IowaScaledEngineering/mrbw-cabbus/doc/lab/2018-02-05-cabbus.png

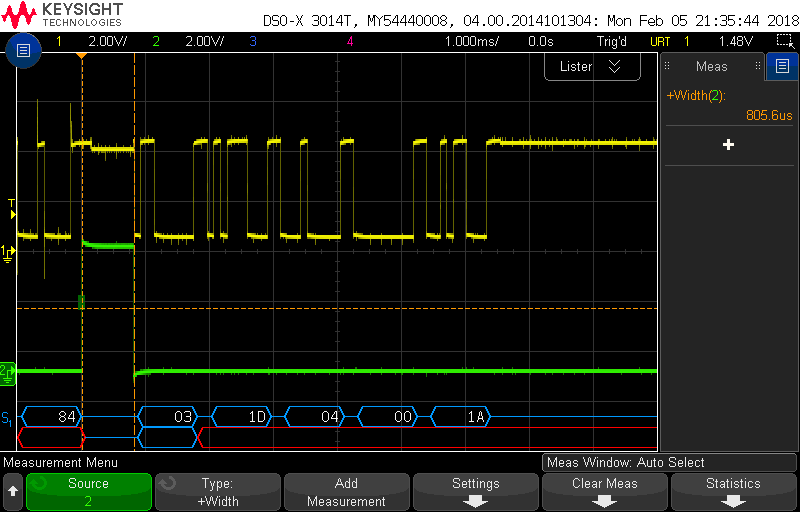
doc/lab/2018-02-05-cabbus.png
