IowaScaledEngineering/mrbw-cabbus/doc/lab/2018-02-05-xpressnet-1.png

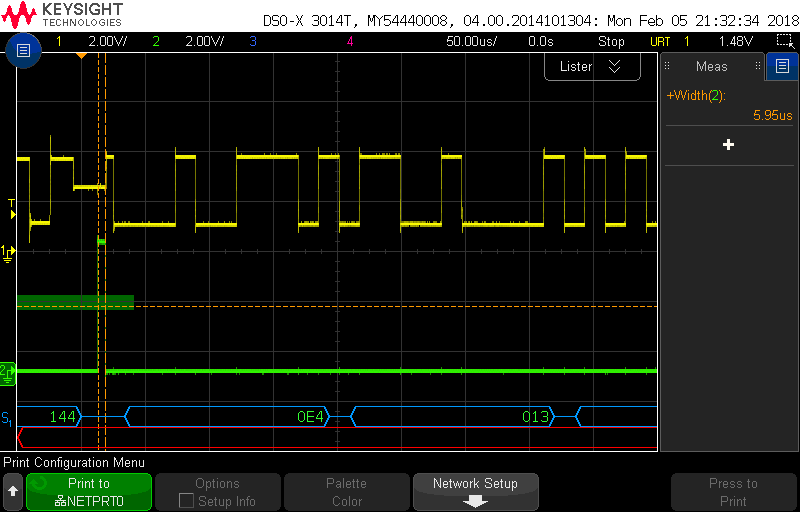
doc/lab/2018-02-05-xpressnet-1.png
