IowaScaledEngineering/mrbw-cabbus/pg/mrbw-cabbus-v2.3-62b0684/mrbw-cabbus.pdf

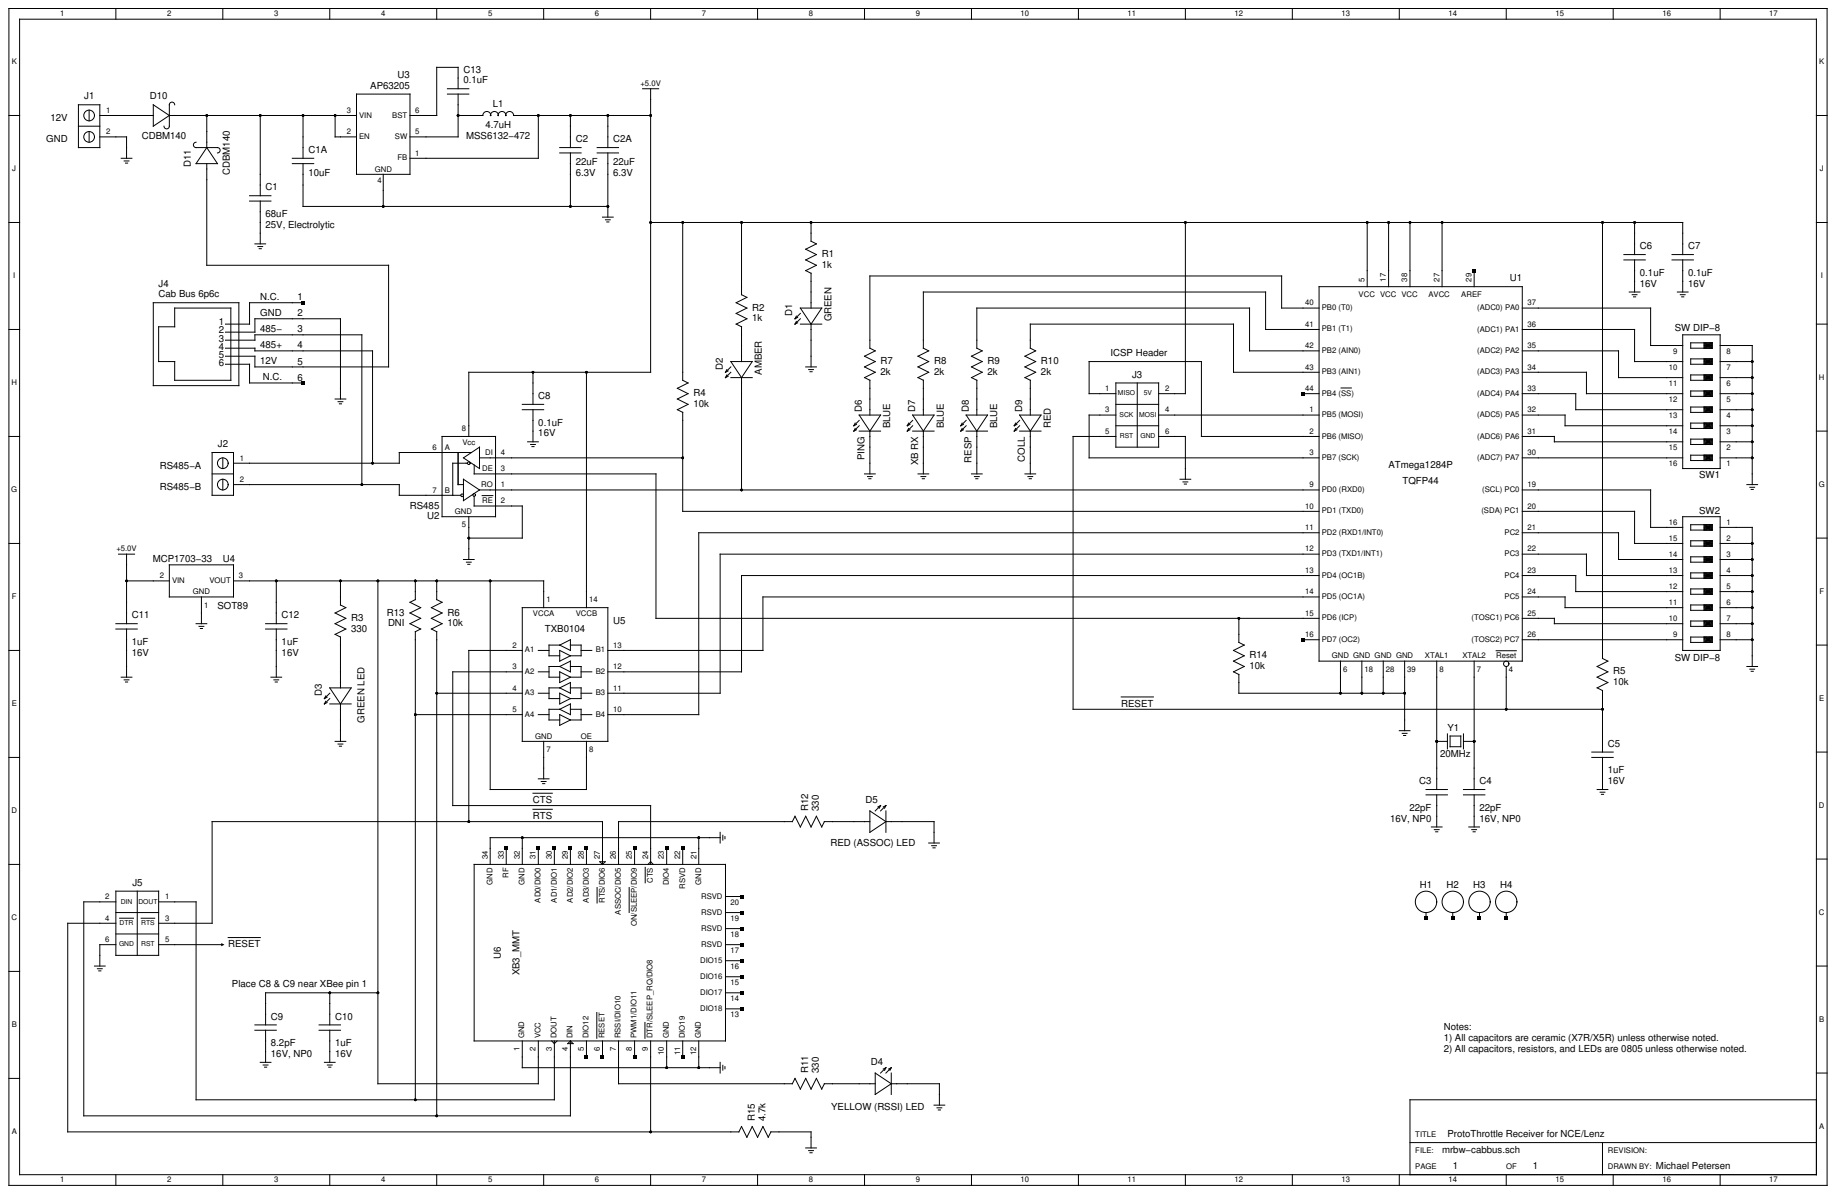
[picture p14: page 1]

32 (ADC5) PA5 | | 12 | 5

SCK | MOSI | | | 31 (ADC6) PA6 30 (ADC7) PA7 | 13 | 4

Place C8 & C9 near XBee pin 1

Notes:
1) All capacitors are ceramic (X7R/X5R) unless otherwise noted.
2) All capacitors, resistors, and LEDs are 0805 unless otherwise noted.

ProtoThrottle Receiver for NCE/Lenz
mrbw−cabbus.sch
