IowaScaledEngineering/mrbw-cabbus/pg/mrbw-cabbus-v2.2-60de8c5/mrbw-cabbus-pcb.pdf

# mrbw-cabbus.pcb

# 1. Table of Contents (This Page) Created on Sun Sep 13 12:15:43 2020

# 2. top 3. bottom 4. outline 5. plated-drill 6. unplated-drill 7. componentmask 8. soldermask 9. topsilk 10. bottomsilk 11. toppaste 12. topassembly 13. bottomassembly 14. fab

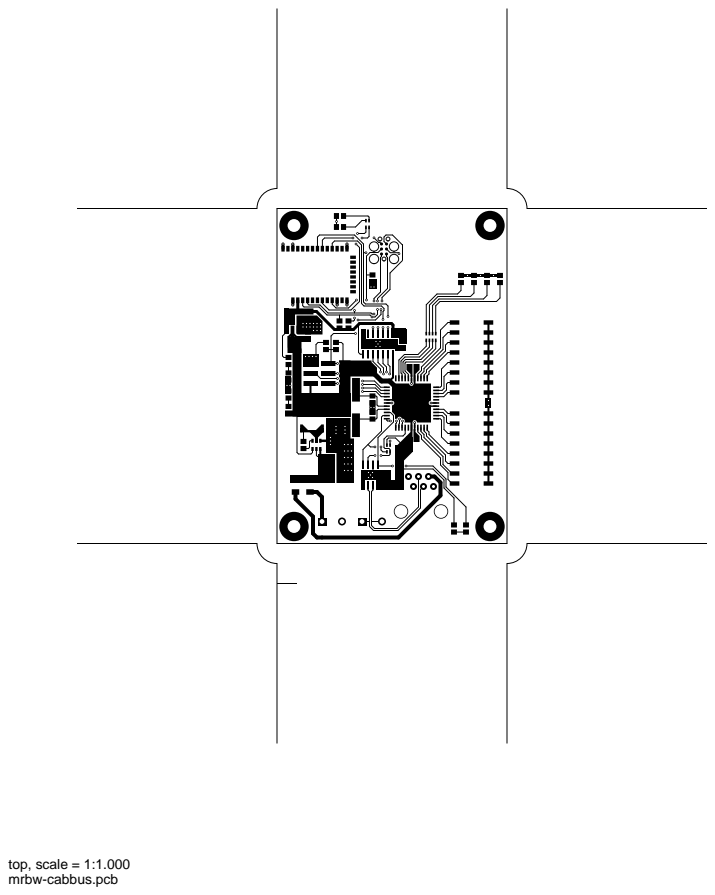
[picture p15: page 2]
top, scale = 1:1.000

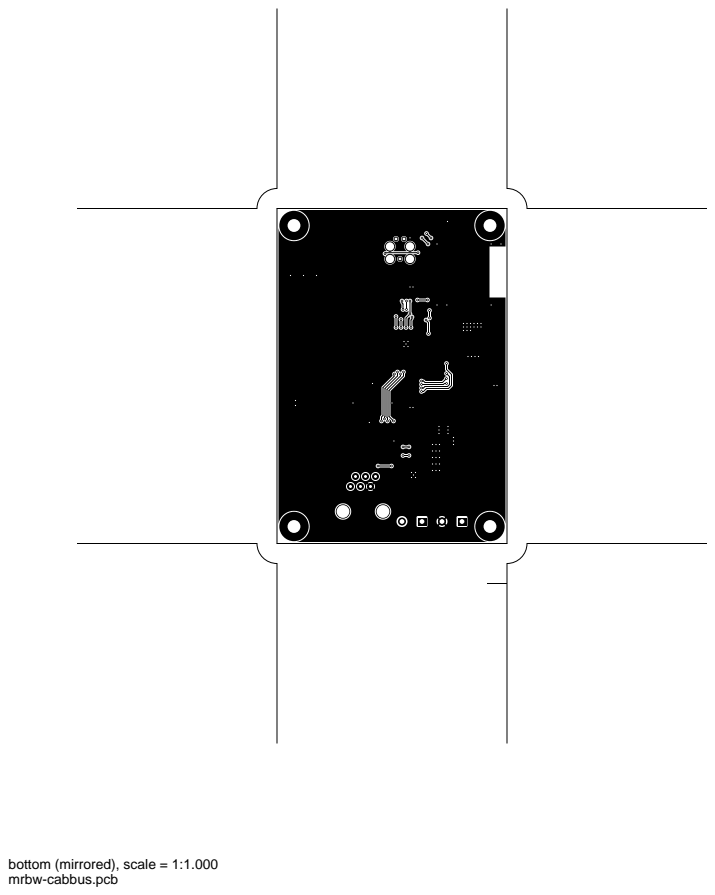
[picture p16: page 3]

bottom (mirrored), scale = 1:1.000

outline, scale = 1:1.000

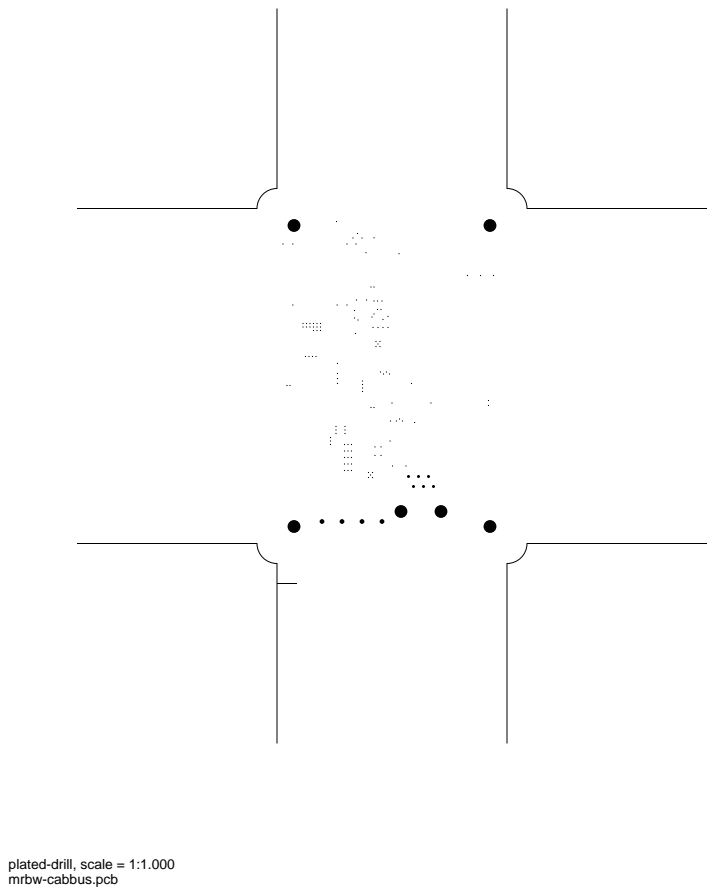
[picture p17: page 5]

plated-drill, scale = 1:1.000

unplated-drill, scale = 1:1.000

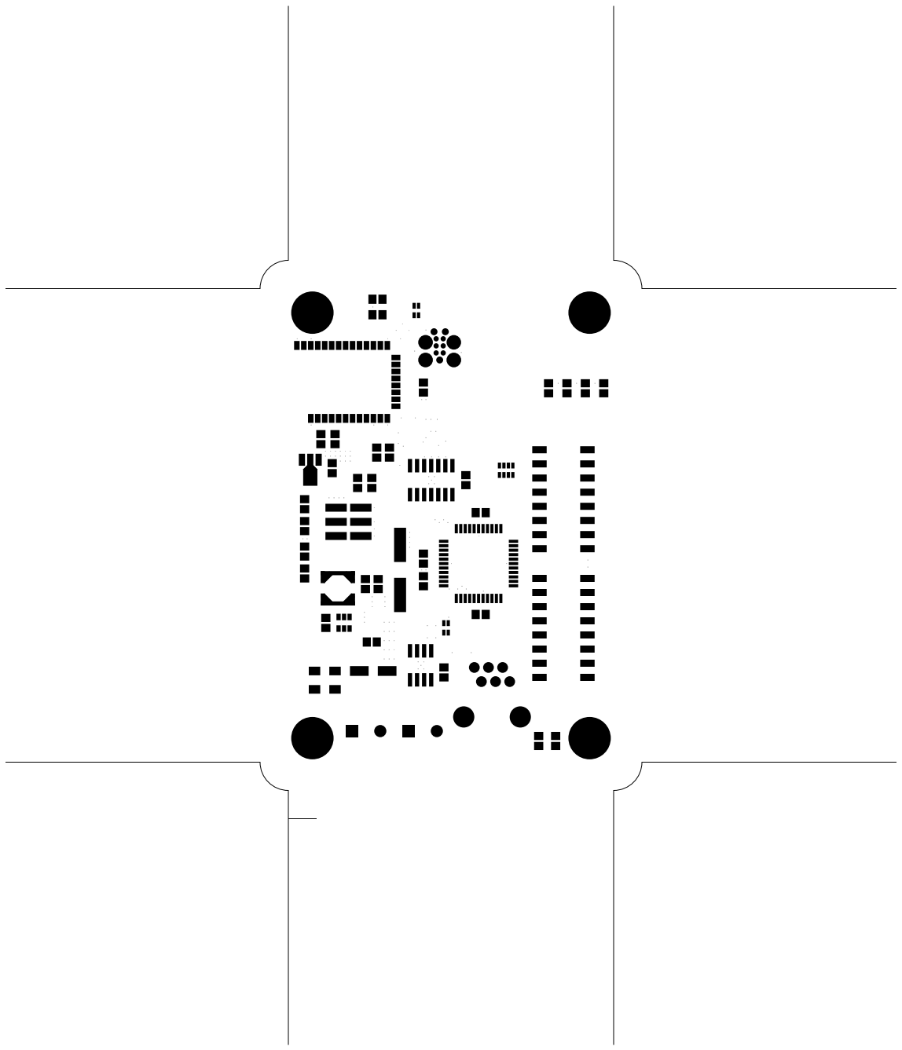
[picture p18: figure]

topmask, scale = 1:1.000

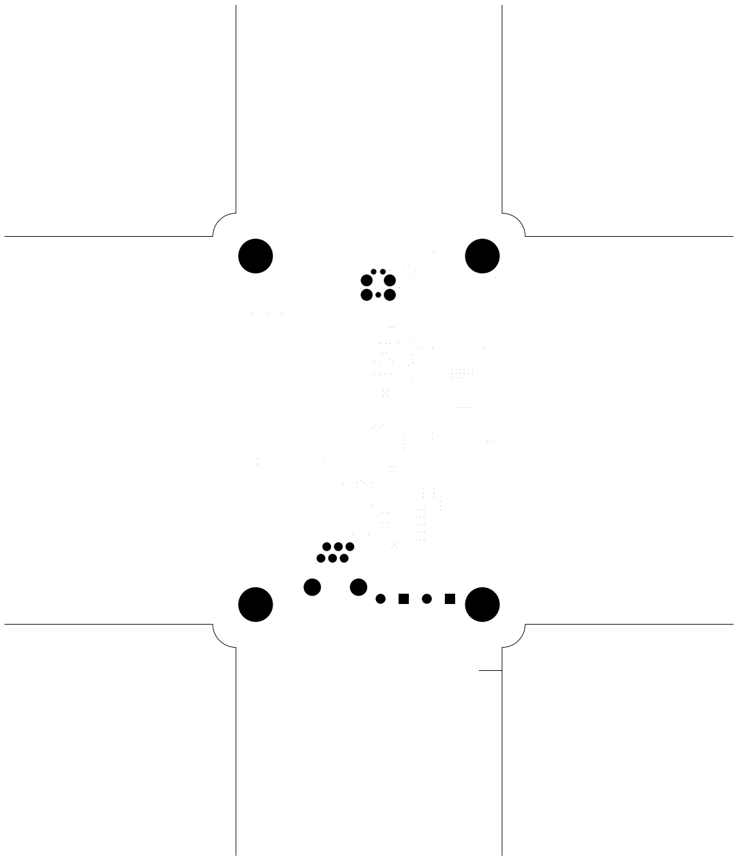
[picture p19: figure]

bottommask (mirrored), scale = 1:1.000

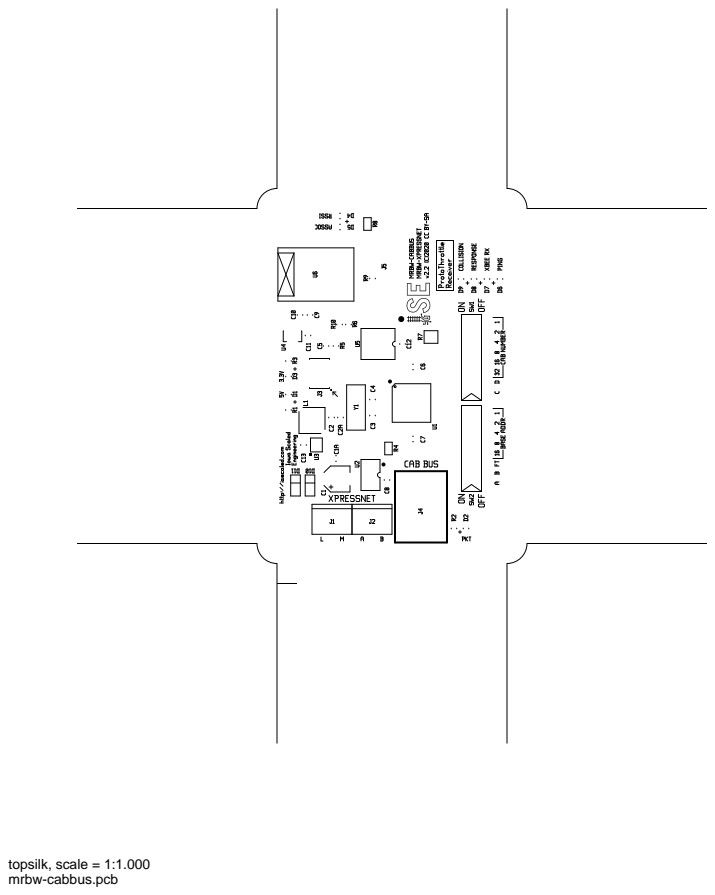
[picture p20: page 9]
topsilk, scale = 1:1.000

bottomsilk (mirrored), scale = 1:1.000

toppaste, scale = 1:1.000

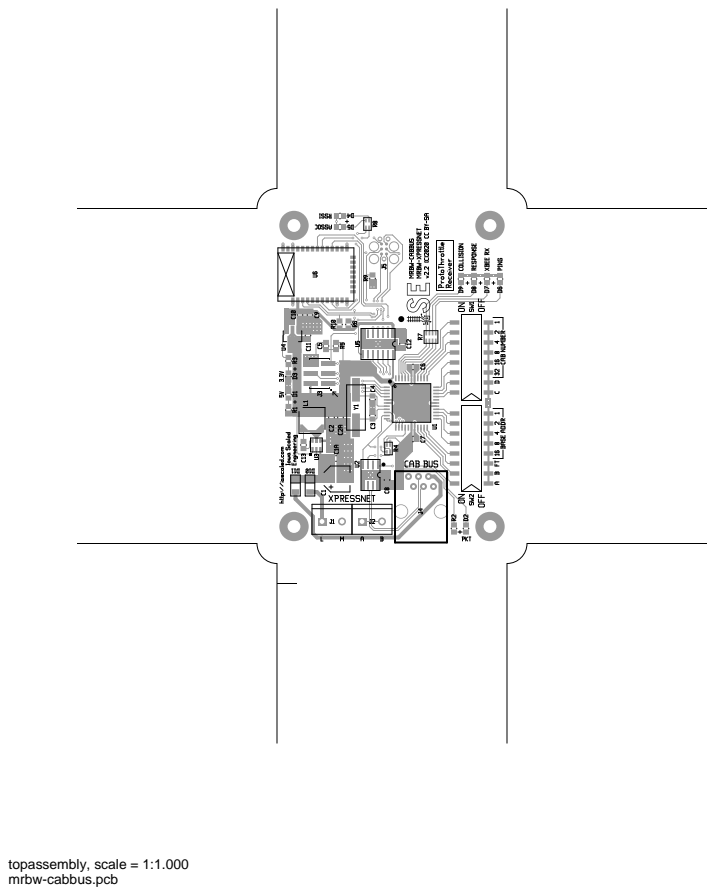
[picture p21: page 12]
topassembly, scale = 1:1.000

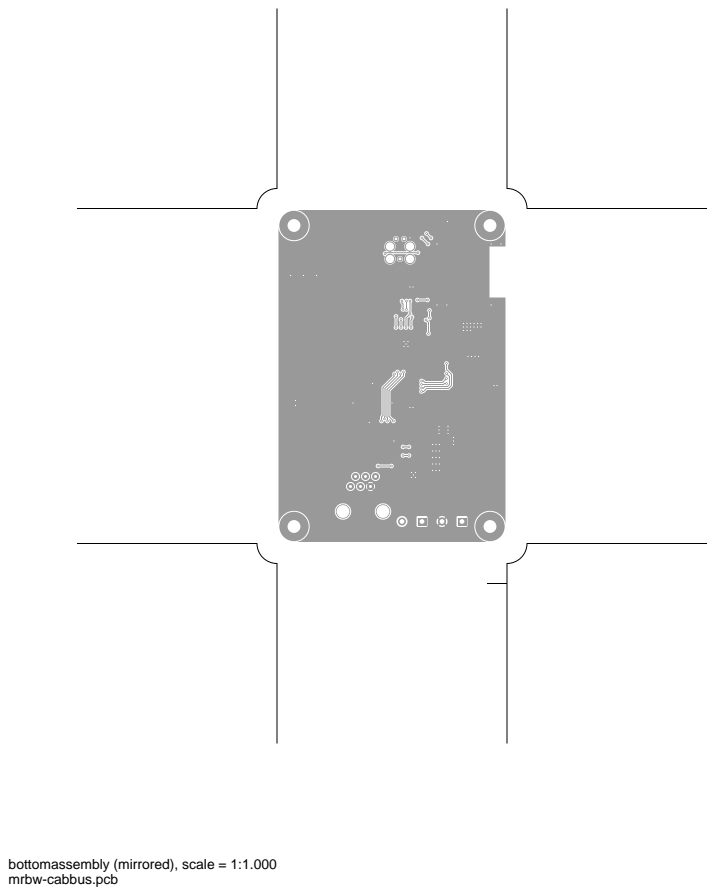
[picture p22: page 13]

bottomassembly (mirrored), scale = 1:1.000

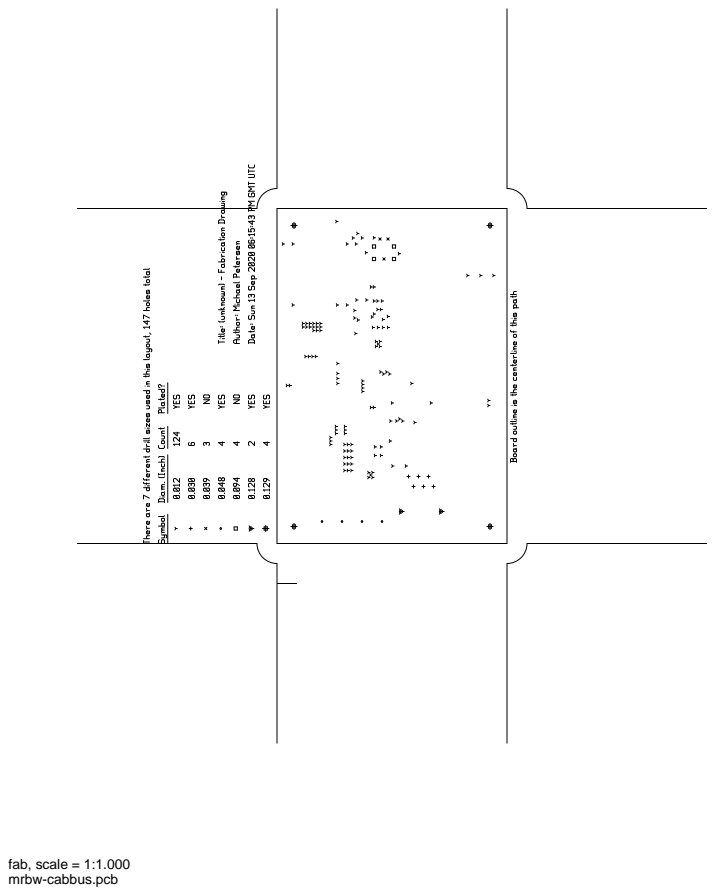
[picture p23: page 14]
fab, scale = 1:1.000
