IowaScaledEngineering/mrbw-cabbus/pg/mrbw-cabbus-v2.1-f0899d0/mrbw-cabbus-pcb.pdf

# mrbw-cabbus.pcb

# 1. Table of Contents (This Page) Created on Fri Dec 13 20:47:04 2019

# 2. top 3. bottom 4. outline 5. plated-drill 6. unplated-drill 7. componentmask 8. soldermask 9. topsilk 10. bottomsilk 11. toppaste 12. topassembly 13. bottomassembly 14. fab

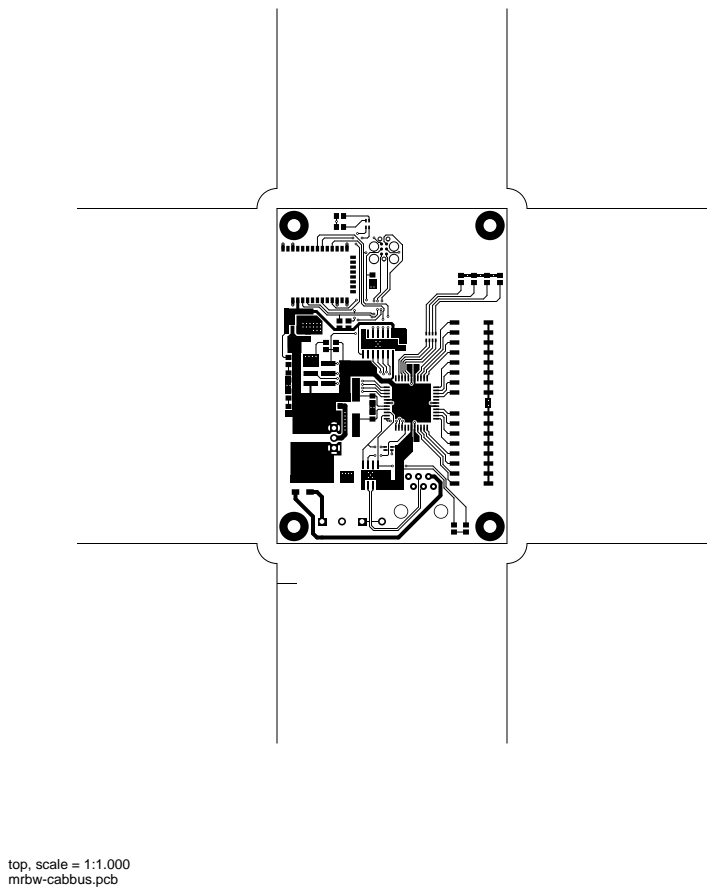
[picture p24: page 2]
top, scale = 1:1.000

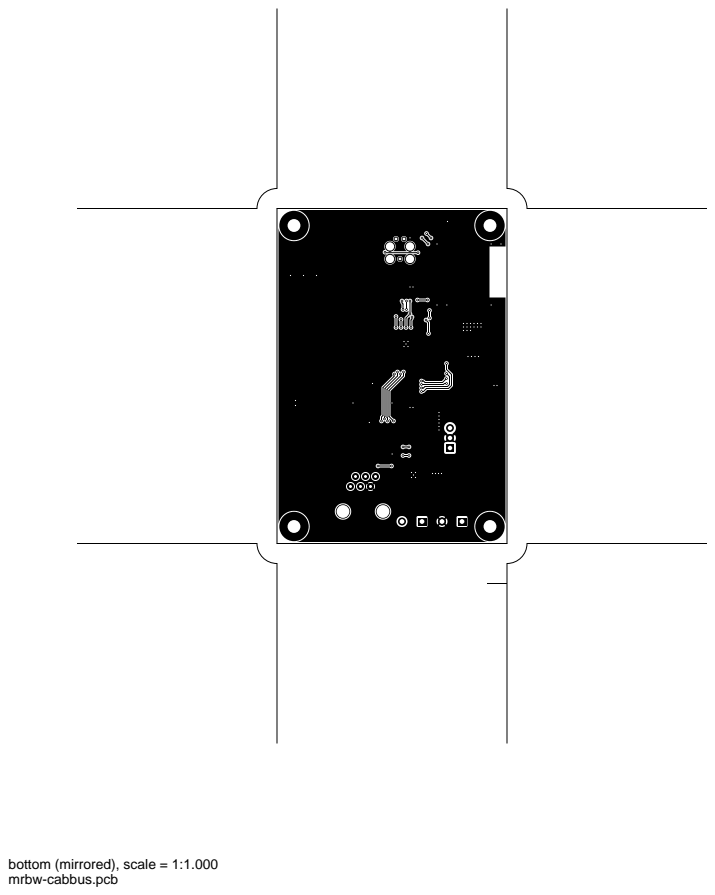
[picture p25: page 3]

bottom (mirrored), scale = 1:1.000

outline, scale = 1:1.000

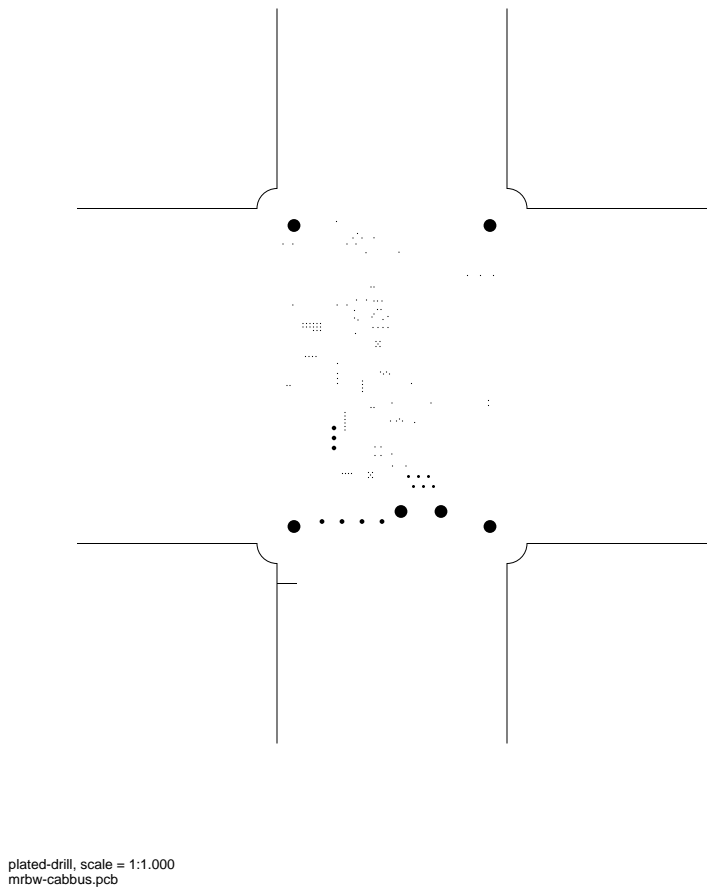
[picture p26: page 5]

plated-drill, scale = 1:1.000

unplated-drill, scale = 1:1.000

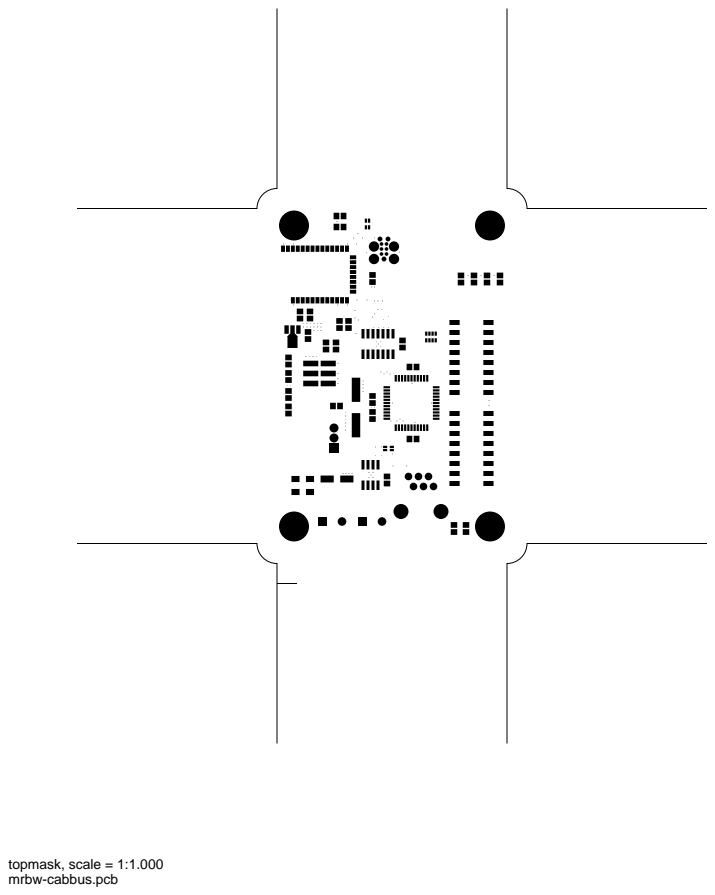
[picture p27: page 7]
topmask, scale = 1:1.000

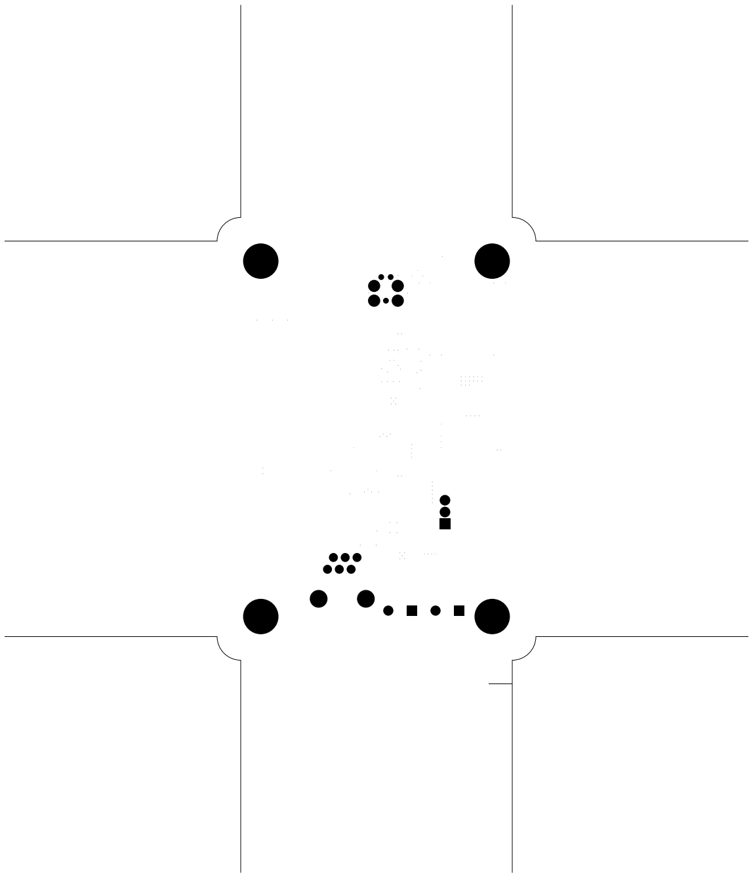
[picture p28: figure]

bottommask (mirrored), scale = 1:1.000

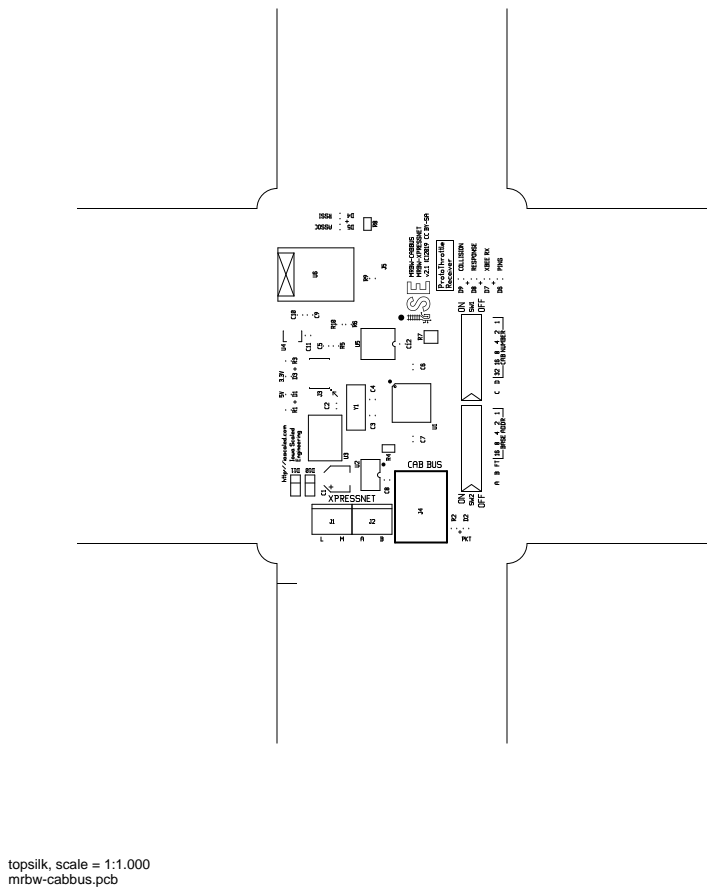
[picture p29: page 9]
topsilk, scale = 1:1.000

bottomsilk (mirrored), scale = 1:1.000

toppaste, scale = 1:1.000

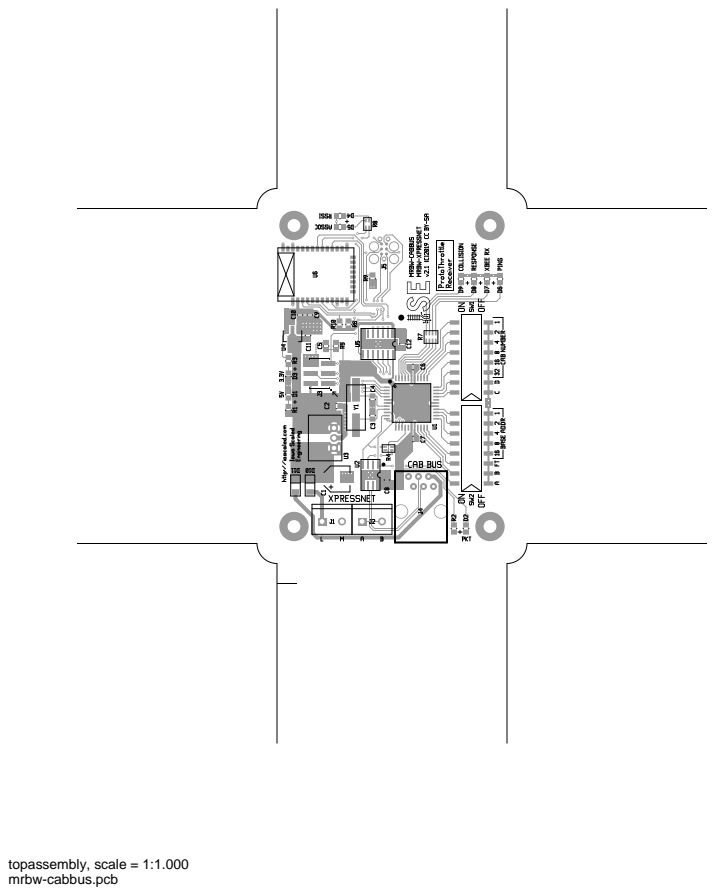
[picture p30: page 12]
topassembly, scale = 1:1.000

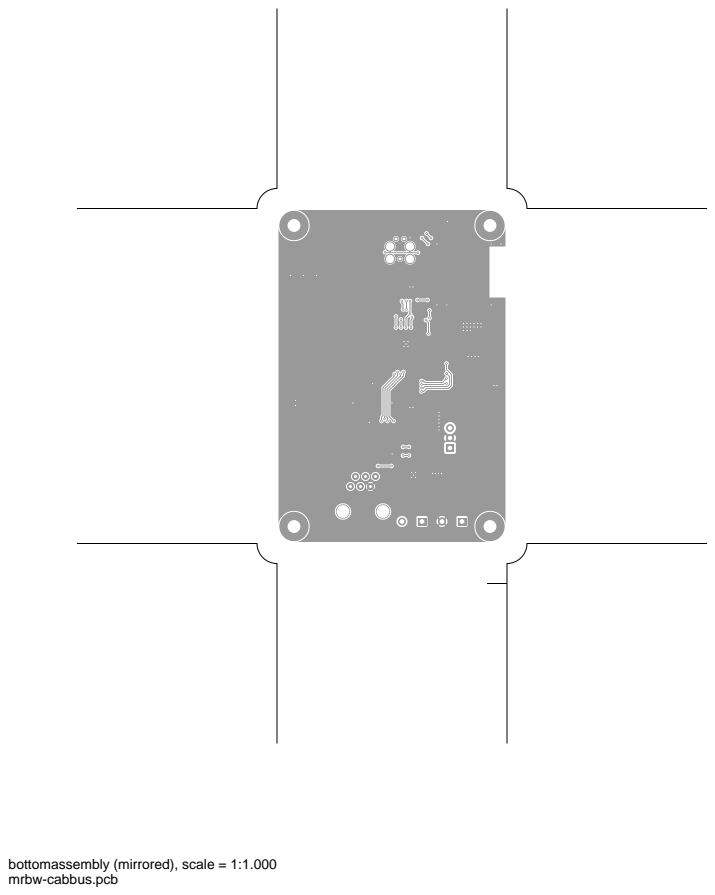
[picture p31: page 13]

bottomassembly (mirrored), scale = 1:1.000

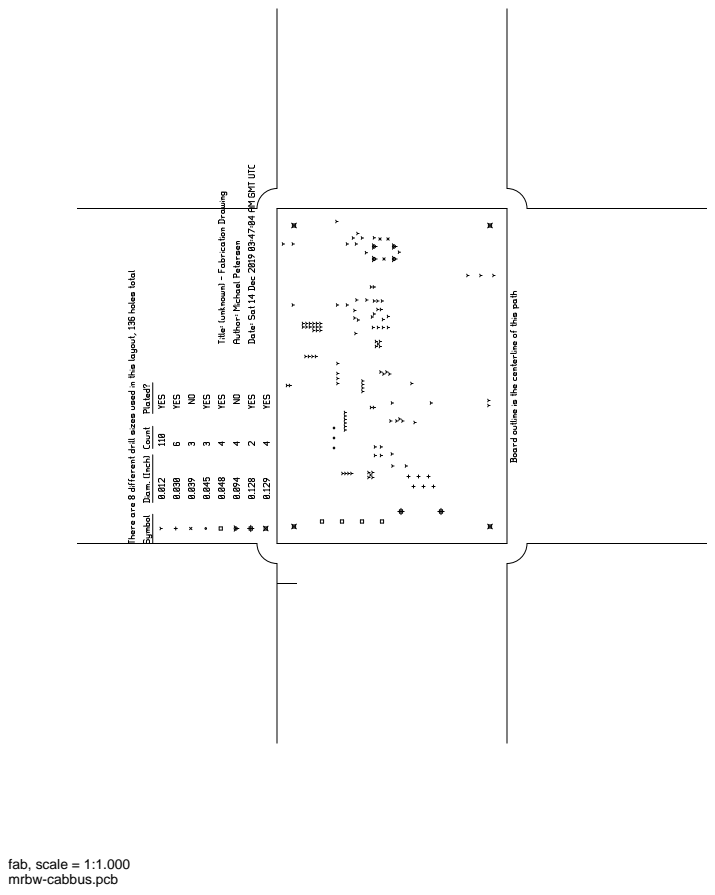
[picture p32: page 14]
fab, scale = 1:1.000
