IowaScaledEngineering/mrbw-cabbus/pg/mrbw-cabbus-v2.0-a83616d/mrbw-cabbus-pcb.pdf

# mrbw-cabbus.pcb

# 1. Table of Contents (This Page) Created on Mon Feb 25 21:30:20 2019

# 2. top 3. bottom 4. outline 5. plated-drill 6. unplated-drill 7. componentmask 8. soldermask 9. topsilk 10. bottomsilk 11. toppaste 12. topassembly 13. bottomassembly 14. fab

top, scale = 1:1.000


bottom (mirrored), scale = 1:1.000

outline, scale = 1:1.000


plated-drill, scale = 1:1.000

unplated-drill, scale = 1:1.000

topmask, scale = 1:1.000


bottommask (mirrored), scale = 1:1.000

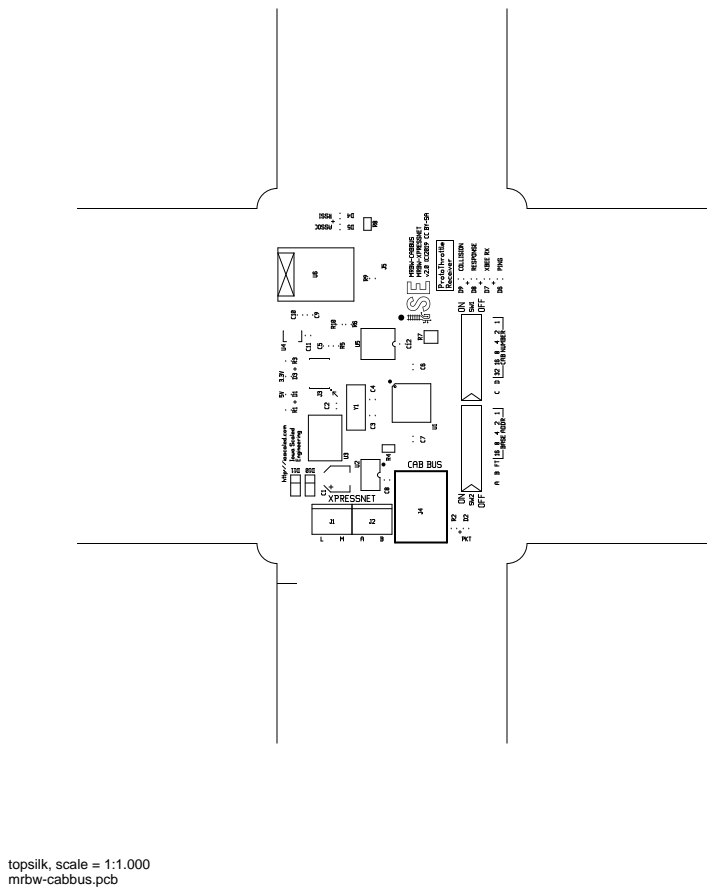
[picture p33: page 9]
topsilk, scale = 1:1.000

bottomsilk (mirrored), scale = 1:1.000

toppaste, scale = 1:1.000

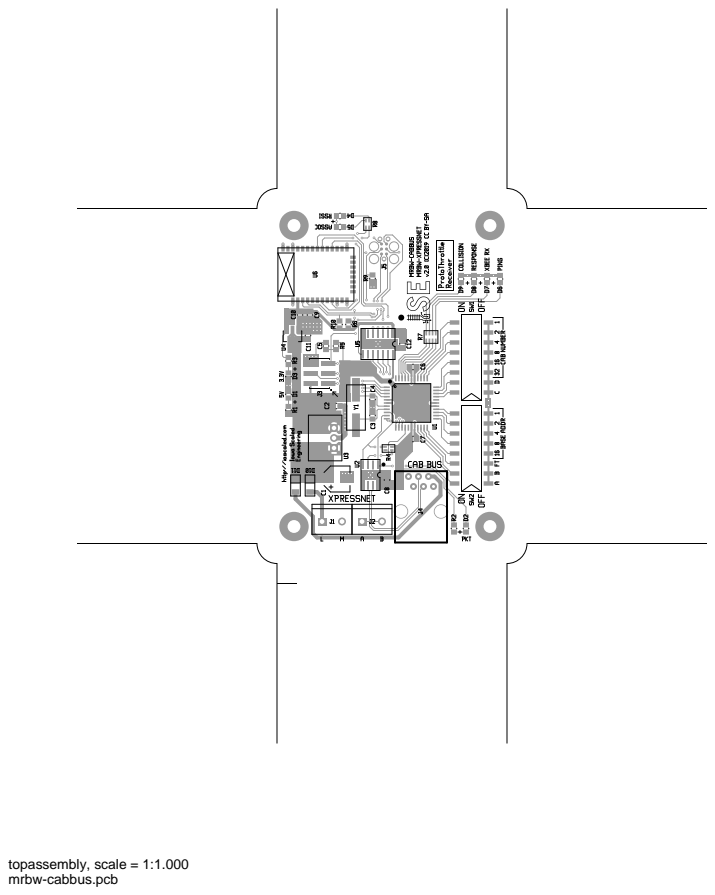
[picture p34: page 12]
topassembly, scale = 1:1.000


bottomassembly (mirrored), scale = 1:1.000

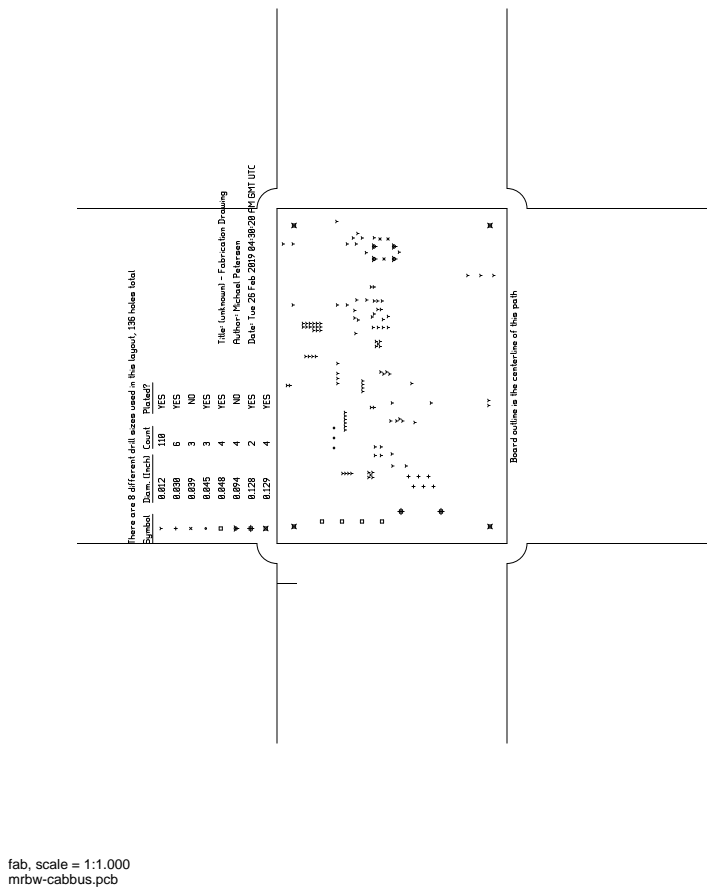
[picture p35: page 14]
fab, scale = 1:1.000
