IowaScaledEngineering/mrbw-cabbus/pg/mrbw-cabbus-v1.0-c163588/mrbw-cabbus-pcb.pdf

# mrbw-cabbus.pcb

# 1. Table of Contents (This Page) Created on Tue Jan 2 21:45:06 2018

# 2. top 3. bottom 4. outline 5. plated-drill 6. componentmask 7. soldermask 8. topsilk 9. bottomsilk 10. toppaste 11. topassembly 12. bottomassembly 13. fab

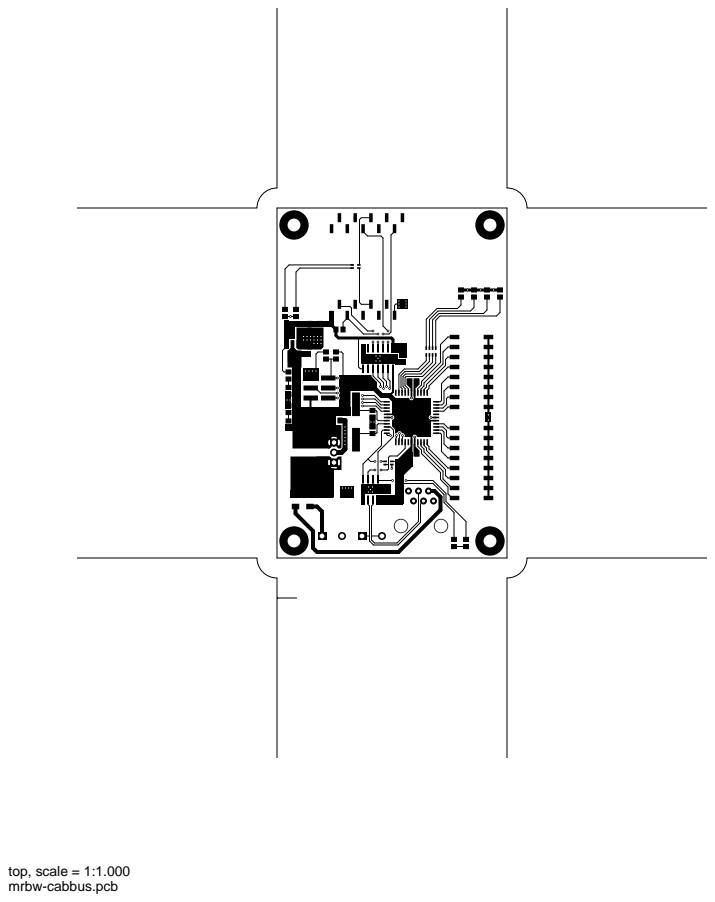
[picture p36: page 2]
top, scale = 1:1.000

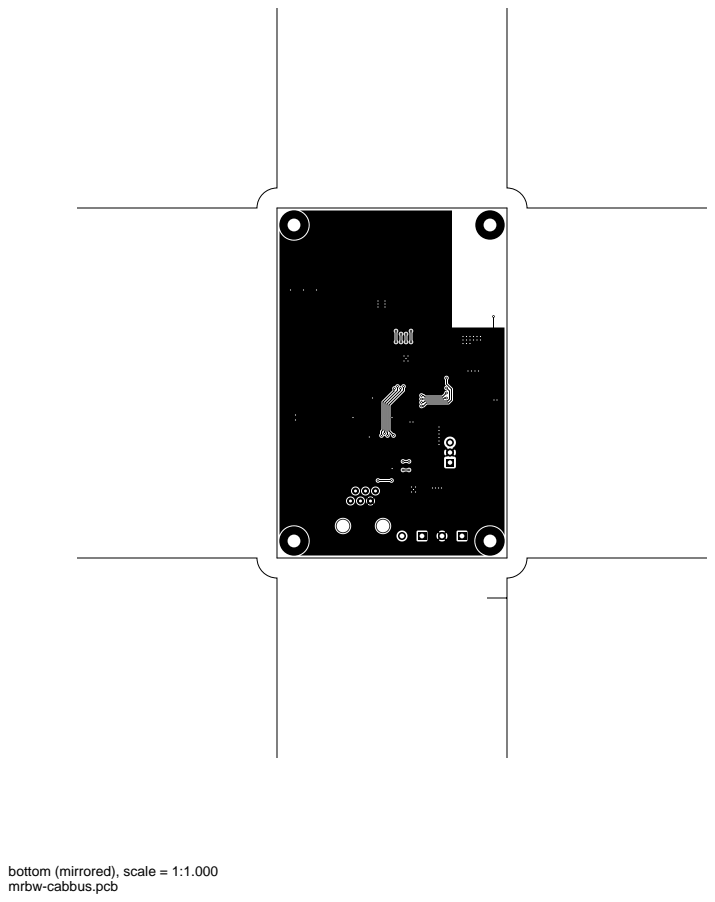
[picture p37: page 3]

bottom (mirrored), scale = 1:1.000

outline, scale = 1:1.000

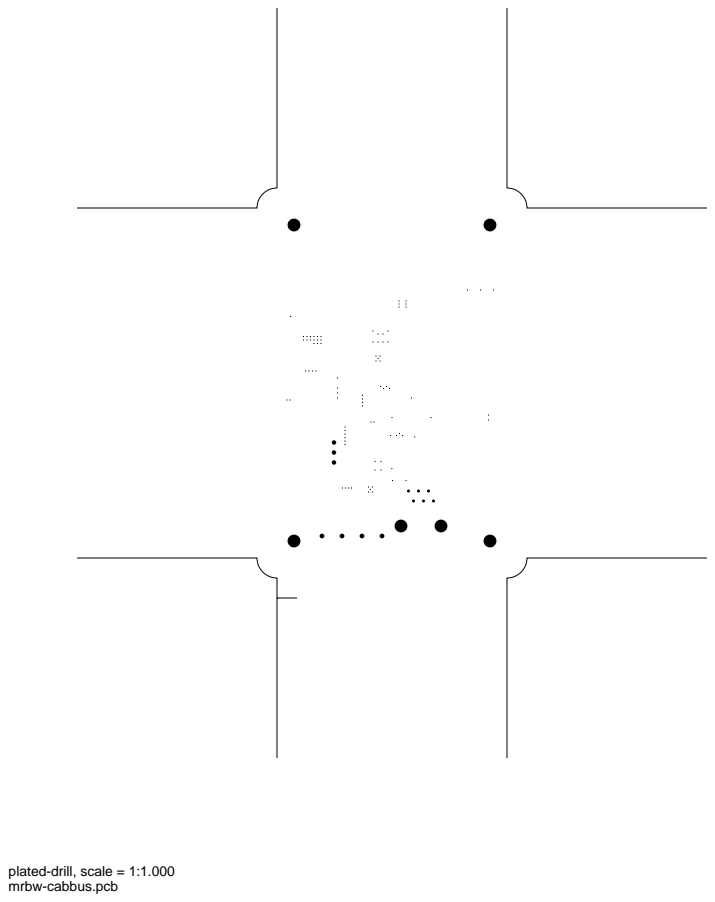
[picture p38: page 5]

plated-drill, scale = 1:1.000

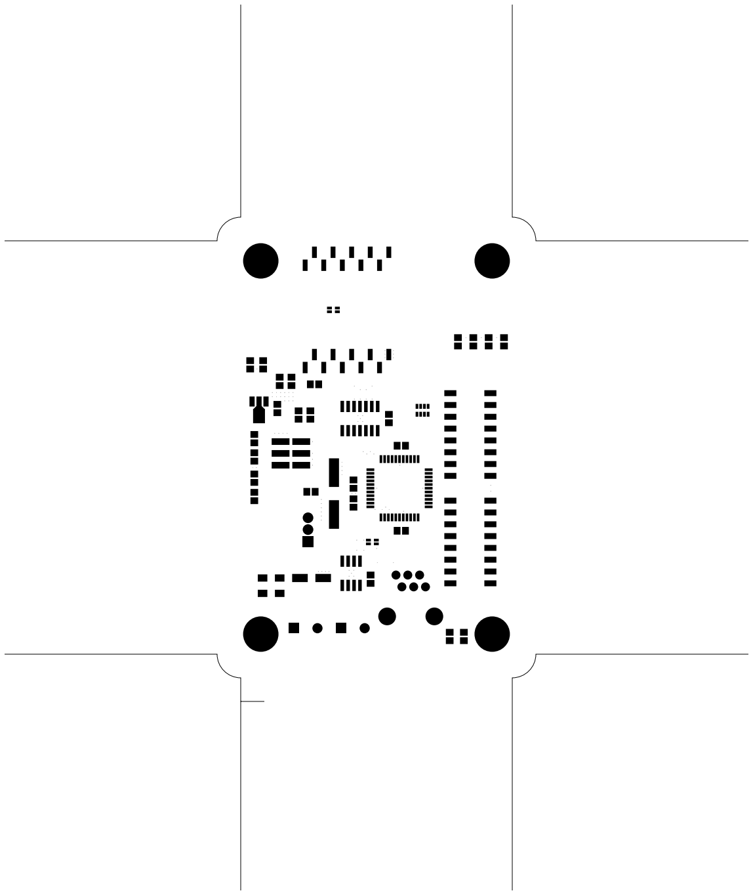
[picture p39: figure]

topmask, scale = 1:1.000

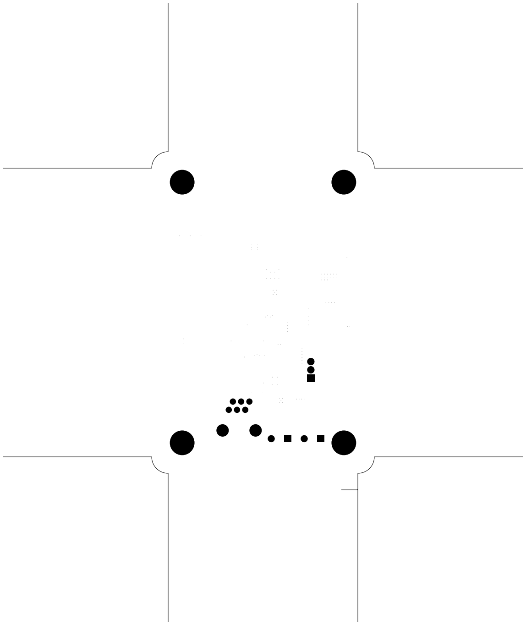
[picture p40: figure]

bottommask (mirrored), scale = 1:1.000

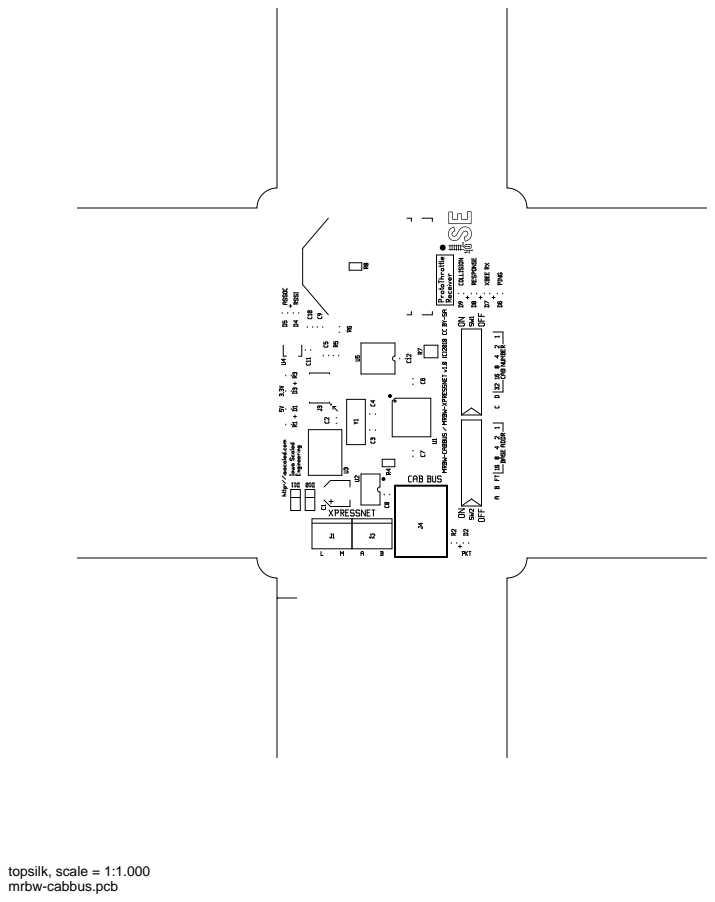
[picture p41: page 8]
topsilk, scale = 1:1.000

bottomsilk (mirrored), scale = 1:1.000

toppaste, scale = 1:1.000

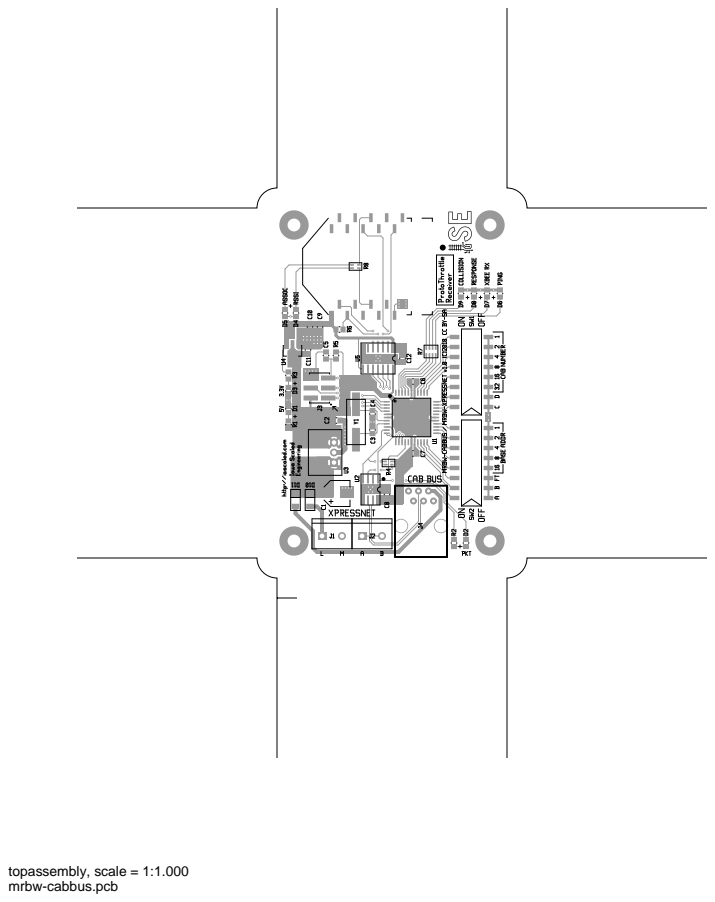
[picture p42: page 11]
topassembly, scale = 1:1.000

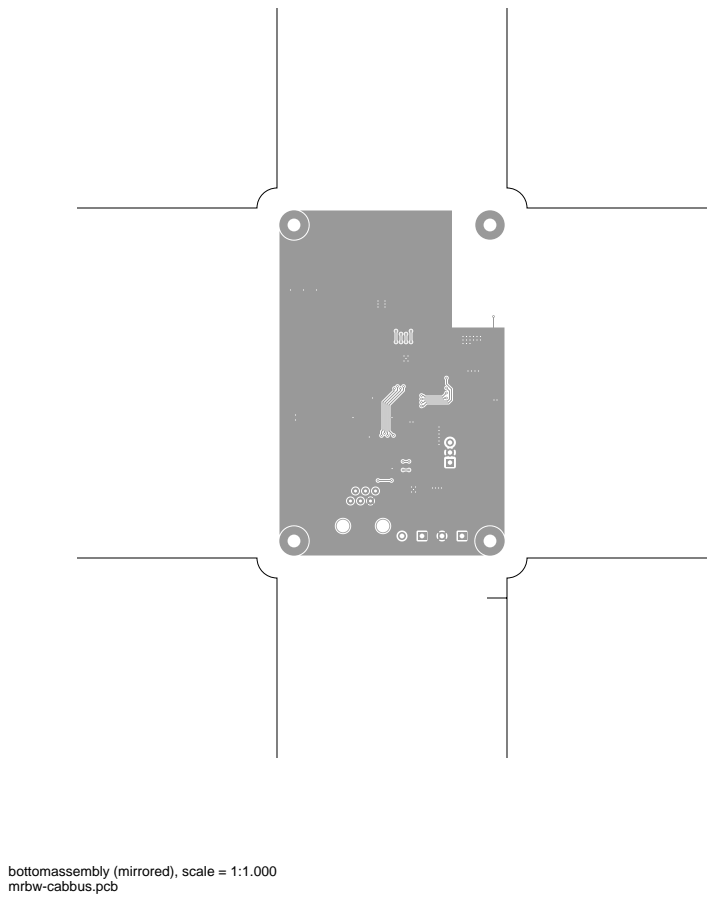
[picture p43: page 12]

bottomassembly (mirrored), scale = 1:1.000

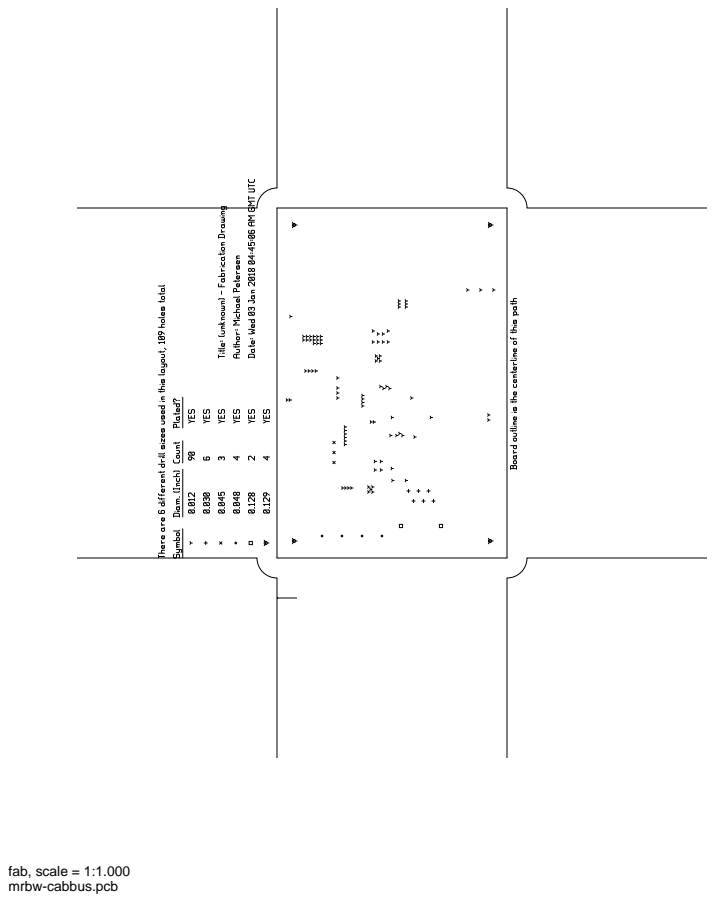
[picture p44: page 13]
fab, scale = 1:1.000
