IowaScaledEngineering/mrbw-cabbus/(list of files, drawings)

Other design files:
pcb/mrbw-cabbus.pcb
