IowaScaledEngineering/mrbw-cabbus/src/mrbw-cabbus.c

/*************************************************************************
Title:    MRBW-CABBUS MRBee Cab Bus Interface
Authors:  Michael D. Petersen <railfan@drgw.net>
          Nathan D. Holmes <maverick@drgw.net>
File:     mrbw-cabbus.c
License:  GNU General Public License v3

LICENSE:
    Copyright (C) 2017 Michael Petersen & Nathan Holmes
    
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
    This program is distributed in the hope that it will be useful,
    but WITHOUT ANY WARRANTY; without even the implied warranty of
    MERCHANTABILITY or FITNESS FOR A PARTICULAR PURPOSE.  See the
    GNU General Public License for more details.
*************************************************************************/

#include <stdlib.h>
#include <avr/io.h>
#include <avr/interrupt.h>
#include <avr/eeprom.h>
#include <avr/wdt.h>
#include <avr/sleep.h>
#include <util/delay.h>
#include <util/atomic.h>
#include "mrbee.h"
#include "cabbus.h"
#include "cabbus-cache.h"

#define LOCO_ADDRESS_SHORT 0x8000

#define TIMEOUT_SECONDS 60
uint8_t mrbusTimer[256] = { 0 };

uint16_t lastLocoAddress = 0;

#define MRBUS_TX_BUFFER_DEPTH 16
#define MRBUS_RX_BUFFER_DEPTH 32

MRBusPacket mrbusTxPktBufferArray[MRBUS_TX_BUFFER_DEPTH];
MRBusPacket mrbusRxPktBufferArray[MRBUS_RX_BUFFER_DEPTH];

#define CABBUS_TX_BUFFER_DEPTH 32
#define CABBUS_RX_BUFFER_DEPTH 8

CabBusPacket cabBusTxPktBufferArray[CABBUS_TX_BUFFER_DEPTH];
CabBusPacket cabBusRxPktBufferArray[CABBUS_RX_BUFFER_DEPTH];
uint8_t cabBusBuffer[CABBUS_BUFFER_SIZE];

uint8_t mrbus_dev_addr = 0;

#define TIME_FLAGS_DISP_FAST       0x01
#define TIME_FLAGS_DISP_FAST_HOLD  0x02
#define TIME_FLAGS_DISP_REAL_AMPM  0x04
#define TIME_FLAGS_DISP_FAST_AMPM  0x08

uint16_t timeScaleFactor = 10;
uint8_t timeFlags = 0;

typedef struct
{
	uint8_t seconds;
	uint8_t minutes;
	uint8_t hours;
	uint8_t dayOfWeek;
	uint8_t day;
	uint8_t month;
	uint16_t year;
} TimeData;

TimeData fastTime;
uint8_t enableFastTime = 0;

uint8_t enableXpressnet = 0;

// These are in centisecs
#define RESPONSE_LED_TIME   5
#define XBEE_RX_LED_TIME    5
#define PING_LED_TIME       2

uint8_t mrbeeCollisionTimer = 0;
uint8_t cabBuscollisionTimer = 0;
uint8_t responseTimer = 0;
uint8_t xbeeRxTimer = 0;
uint8_t pingTimer = 0;

// Thes are in decisecs
#define COLLISON_LED_TIME   20
#define BLINK_RATE          6
uint8_t blink = 0;

typedef enum
{
	COLLISON,
	RESPONSE,
	XBEE_RX,
	PING,
} StatusLED;

void setLed(StatusLED led)
{
	switch(led)
	{
		case COLLISON:
			PORTB |= _BV(PB3);
			break;
		case RESPONSE:
			PORTB |= _BV(PB2);
			break;
		case XBEE_RX:
			PORTB |= _BV(PB1);
			break;
		case PING:
			PORTB |= _BV(PB0);
			break;
	}
}

void clearLed(StatusLED led)
{
	switch(led)
	{
		case COLLISON:
			PORTB &= ~_BV(PB3);
			break;
		case RESPONSE:
			PORTB &= ~_BV(PB2);
			break;
		case XBEE_RX:
			PORTB &= ~_BV(PB1);
			break;
		case PING:
			PORTB &= ~_BV(PB0);
			break;
	}
}

void createVersionPacket(uint8_t destAddr, uint8_t *buf)
{
	buf[MRBUS_PKT_DEST] = destAddr;
	buf[MRBUS_PKT_SRC] = mrbus_dev_addr;
	buf[MRBUS_PKT_LEN] = enableXpressnet ? 20 : 19;
	buf[MRBUS_PKT_TYPE] = 'v';
	buf[6]  = MRBUS_VERSION_WIRELESS;
	// Software Revision
	buf[7]  = 0xFF & ((uint32_t)(GIT_REV))>>16; // Software Revision
	buf[8]  = 0xFF & ((uint32_t)(GIT_REV))>>8; // Software Revision
	buf[9]  = 0xFF & (GIT_REV); // Software Revision
	buf[10]  = HWREV_MAJOR; // Hardware Major Revision
	buf[11]  = HWREV_MINOR; // Hardware Minor Revision
	buf[12] = enableXpressnet ? 'X' : 'C';
	buf[13] = enableXpressnet ? 'P' : 'A';
	buf[14] = enableXpressnet ? 'R' : 'B';
	buf[15] = enableXpressnet ? 'E' : ' ';
	buf[16] = enableXpressnet ? 'S' : 'B';
	buf[17] = enableXpressnet ? 'N' : 'U';
	buf[18] = enableXpressnet ? 'E' : 'S';
	buf[19] = enableXpressnet ? 'T' : ' ';
}

void createTimePacket(uint8_t *buf)
{
	buf[MRBUS_PKT_SRC] = mrbus_dev_addr;
	buf[MRBUS_PKT_DEST] = 0xFF;
	buf[MRBUS_PKT_LEN] = 18;			
	buf[5] = 'T';
	buf[6] = 0;
	buf[7] = 0;
	buf[8] = 0;
	buf[9] = timeFlags;
	buf[10] = fastTime.hours;
	buf[11] = fastTime.minutes;			
	buf[12] = fastTime.seconds;
	buf[13] = 0xFF & (timeScaleFactor>>8);
	buf[14] = 0xFF & timeScaleFactor;
	buf[15] = 0;
	buf[16] = 0;
	buf[17] = 0;
}

void sendSpeedDirection(uint16_t locoAddress, uint8_t speedDirection)
{
	uint8_t speed = speedDirection & 0x7F;
	uint8_t direction = speedDirection & 0x80;
	if(!enableXpressnet && (1 == speed))
	{
		// E-stop for Cab Bus only (XpressNet handles it as part of speed & direction)
		cabBusBuffer[0] = (locoAddress >> 7) & 0x7F;  // Locomotive Address
		cabBusBuffer[1] = locoAddress & 0x7F;
		cabBusBuffer[2] = (direction) ? 0x06 : 0x05;  // Direction for E-stop
		cabBusBuffer[3] = 0;
		cabBusPktQueuePush(&cabBusTxQueue, cabBusBuffer, 4);
	}
	else
	{
		// Speed and direction
		if(enableXpressnet)
		{
			cabBusBuffer[0] = 0xE4;  // Speed & Direction, 128 speed steps
			cabBusBuffer[1] = 0x13;
			cabBusBuffer[2] = (locoAddress >> 8) & 0xFF;  // Locomotive Address
			cabBusBuffer[3] = locoAddress & 0xFF;
			cabBusBuffer[4] = speedDirection;
			cabBusPktQueuePush(&cabBusTxQueue, cabBusBuffer, 5);
		}
		else
		{
			cabBusBuffer[0] = (locoAddress >> 7) & 0x7F;  // Locomotive Address
			cabBusBuffer[1] = locoAddress & 0x7F;
			cabBusBuffer[2] = (direction) ? 0x04 : 0x03;  // Direction for 128 speed step
			cabBusBuffer[3] = speed ? speed-1 : 0;  // Speed
			cabBusPktQueuePush(&cabBusTxQueue, cabBusBuffer, 4);
		}
	}
	lastLocoAddress = locoAddress;
}
void PktHandler(void)
{
	uint16_t crc = 0;
	uint8_t i;
	uint8_t rxBuffer[MRBUS_BUFFER_SIZE];
	uint8_t txBuffer[MRBUS_BUFFER_SIZE];
	
	if (0 == mrbusPktQueuePop(&mrbeeRxQueue, rxBuffer, sizeof(rxBuffer)))
		return;

	//*************** PACKET FILTER ***************
	// Since this is MRBee, we don't get copies of our own transmissions
	// Therefore, if the incoming packet has our address as the source, someone else is out there talking
	if (rxBuffer[MRBUS_PKT_SRC] == mrbus_dev_addr)
	{
		mrbeeCollisionTimer = COLLISON_LED_TIME;
		goto	PktIgnore;
	}

	// Destination Test - is this for us?  If not, ignore.
	// Also ignore broadcast packets, which is a little unconventional for MRBus nodes.  This helps avoid unrelated MRBus packets from causing havoc here.
	if (mrbus_dev_addr != rxBuffer[MRBUS_PKT_DEST])
		goto	PktIgnore;
	
	// CRC16 Test - is the packet intact?
	for(i=0; i<rxBuffer[MRBUS_PKT_LEN]; i++)
	{
		if ((i != MRBUS_PKT_CRC_H) && (i != MRBUS_PKT_CRC_L)) 
			crc = mrbusCRC16Update(crc, rxBuffer[i]);
	}
	if ((UINT16_HIGH_BYTE(crc) != rxBuffer[MRBUS_PKT_CRC_H]) || (UINT16_LOW_BYTE(crc) != rxBuffer[MRBUS_PKT_CRC_L]))
		goto	PktIgnore;
		
	//*************** END PACKET FILTER ***************


	//*************** PACKET HANDLER - PROCESS HERE ***************

	// Just smash the transmit buffer if we happen to see a packet directed to us
	// that requires an immediate response
	//
	// If we're in here, then either we're transmitting, then we can't be 
	// receiving from someone else, or we failed to transmit whatever we were sending
	// and we're waiting to try again.  Either way, we're not going to corrupt an
	// in-progress transmission.
	//
	// All other non-immediate transmissions (such as scheduled status updates)
	// should be sent out of the main loop so that they don't step on things in
	// the transmit buffer
	
	if ('A' == rxBuffer[MRBUS_PKT_TYPE])
	{
		// PING packet
		txBuffer[MRBUS_PKT_DEST] = rxBuffer[MRBUS_PKT_SRC];
		txBuffer[MRBUS_PKT_SRC] = mrbus_dev_addr;
		txBuffer[MRBUS_PKT_LEN] = 6;
		txBuffer[MRBUS_PKT_TYPE] = 'a';
		mrbusPktQueuePush(&mrbeeTxQueue, txBuffer, txBuffer[MRBUS_PKT_LEN]);
		goto PktIgnore;
	} 
	else if ('W' == rxBuffer[MRBUS_PKT_TYPE]) 
	{
		// EEPROM WRITE Packet
		txBuffer[MRBUS_PKT_DEST] = rxBuffer[MRBUS_PKT_SRC];
		txBuffer[MRBUS_PKT_LEN] = 8;			
		txBuffer[MRBUS_PKT_TYPE] = 'w';
		eeprom_write_byte((uint8_t*)(uint16_t)rxBuffer[6], rxBuffer[7]);
		txBuffer[6] = rxBuffer[6];
		txBuffer[7] = rxBuffer[7];
		if (MRBUS_EE_DEVICE_ADDR == rxBuffer[6])
			mrbus_dev_addr = eeprom_read_byte((uint8_t*)MRBUS_EE_DEVICE_ADDR);
		txBuffer[MRBUS_PKT_SRC] = mrbus_dev_addr;
		mrbusPktQueuePush(&mrbeeTxQueue, txBuffer, txBuffer[MRBUS_PKT_LEN]);
		goto PktIgnore;	
	}
	else if ('R' == rxBuffer[MRBUS_PKT_TYPE]) 
	{
		// EEPROM READ Packet
		txBuffer[MRBUS_PKT_DEST] = rxBuffer[MRBUS_PKT_SRC];
		txBuffer[MRBUS_PKT_SRC] = mrbus_dev_addr;
		txBuffer[MRBUS_PKT_LEN] = 8;			
		txBuffer[MRBUS_PKT_TYPE] = 'r';
		txBuffer[6] = rxBuffer[6];
		txBuffer[7] = eeprom_read_byte((uint8_t*)(uint16_t)rxBuffer[6]);			
		mrbusPktQueuePush(&mrbeeTxQueue, txBuffer, txBuffer[MRBUS_PKT_LEN]);
		goto PktIgnore;
	}
	else if ('V' == rxBuffer[MRBUS_PKT_TYPE]) 
	{
		// Version
		createVersionPacket(rxBuffer[MRBUS_PKT_SRC], txBuffer);
		mrbusPktQueuePush(&mrbeeTxQueue, txBuffer, txBuffer[MRBUS_PKT_LEN]);
		goto PktIgnore;
	}
	else if ('X' == rxBuffer[MRBUS_PKT_TYPE]) 
	{
		// Reset
		cli();
		wdt_reset();
		MCUSR &= ~(_BV(WDRF));
		WDTCSR |= _BV(WDE) | _BV(WDCE);
		WDTCSR = _BV(WDE);
		while(1);  // Force a watchdog reset
		sei();
	}
	else if (('S' == rxBuffer[MRBUS_PKT_TYPE]) && (mrbus_dev_addr == rxBuffer[MRBUS_PKT_DEST]))
	{
		// Status packet and addressed to us
		CabData c;
		xbeeRxTimer = XBEE_RX_LED_TIME;

		mrbusTimer[rxBuffer[MRBUS_PKT_SRC]] = TIMEOUT_SECONDS;

		c.locoAddress = ((uint16_t)rxBuffer[6] << 8) + rxBuffer[7];
		if(enableXpressnet)
		{
			// Remove short address flag since XpressNet doesn't care (assumes <100 = short).  See section 1.3 of the XpressNet Protocol document.
			c.locoAddress &= ~(LOCO_ADDRESS_SHORT);
			
			// Range check
			if(c.locoAddress > 9999)
				c.locoAddress = 9999;

			// Set high bits if address is 100 or greater (assumed to be long address)
			if(c.locoAddress > 99)
				c.locoAddress |= 0xC000;
		}
		else
		{
			if(c.locoAddress & LOCO_ADDRESS_SHORT)
			{
				// Short Address
				c.locoAddress &= ~(LOCO_ADDRESS_SHORT);
				if(c.locoAddress > 127)
					c.locoAddress = 0x27FF;
				else
					c.locoAddress += 0x2780;
			}
			else
			{
				// Long Address
				if(c.locoAddress > 9999)
					c.locoAddress = 0x270F;
			}
		}
		
		c.speedDirection = rxBuffer[8];

		//  Yeah, yeah, not elegant but copied from code I knew worked and consolidated it here
		uint32_t functions = ((uint32_t)rxBuffer[9] << 24) + ((uint32_t)rxBuffer[10] << 16) + ((uint16_t)rxBuffer[11] << 8) + rxBuffer[12];
		c.functionGroup1 = ((functions & 0x01) << 4) | ((functions & 0x1E) >> 1);  // F0 F4 F3 F2 F1
		c.functionGroup2 = (functions >> 5) & 0xF;  // F8 F7 F6 F5
		c.functionGroup3 = (functions >> 9) & 0xF;  // F12 F11 F10 F9
		c.functionGroup4 = (functions >> 13) & 0xFF;  // F20 - F13
		c.functionGroup5 = (functions >> 21) & 0xFF;  // F28 - F21

//      Not used at the moment, so comment out to suppress compiler warnings
//		uint8_t statusFlags = rxBuffer[13];

		uint8_t delta = compareCabData(rxBuffer[MRBUS_PKT_SRC], &c);

		// Policy for sending updates:
		//    1) Locomotive address changed.  This throttle was controlling a different locomotive before, so update everything.
		//    2) Certain items have changed since last time.  Update only those items that changed.
		//    3) No changes since last time.  Update speed and direction only.
		//    4) Cab Bus Only: If the loco address of a function packet is different than the last sent speed/direction, send speed/direction
		//         - Addresses caching issue with consist address on Smart Cabs

		if( IS_LOCO_ADDRESS_CHANGED(delta) || IS_SPEED_DIRECTION_CHANGED(delta) || (0 == delta) ||
			(!enableXpressnet && IS_FN_GROUP_CHANGED(delta) && (lastLocoAddress != c.locoAddress)) )
		{
			// Send Speed/Direction
			sendSpeedDirection(c.locoAddress, c.speedDirection);
		}

		// Send function states
		if(IS_LOCO_ADDRESS_CHANGED(delta) || IS_FN_GROUP_1_CHANGED(delta))
		{
			if(enableXpressnet)
			{
				cabBusBuffer[0] = 0xE4;  // Function Group 1
				cabBusBuffer[1] = 0x20;
				cabBusBuffer[2] = (c.locoAddress >> 8) & 0xFF;  // Locomotive Address
				cabBusBuffer[3] = c.locoAddress & 0xFF;
				cabBusBuffer[4] = c.functionGroup1;  // F0 F4 F3 F2 F1
				cabBusPktQueuePush(&cabBusTxQueue, cabBusBuffer, 5);
			}
			else
			{
				cabBusBuffer[0] = (c.locoAddress >> 7) & 0x7F;  // Locomotive Address
				cabBusBuffer[1] = c.locoAddress & 0x7F;
				cabBusBuffer[2] = 0x07;  // Function Group 1
				cabBusBuffer[3] = c.functionGroup1;
				cabBusPktQueuePush(&cabBusTxQueue, cabBusBuffer, 4);
			}
		}

		if(IS_LOCO_ADDRESS_CHANGED(delta) || IS_FN_GROUP_2_CHANGED(delta))
		{
			if(enableXpressnet)
			{
				cabBusBuffer[0] = 0xE4;  // Function Group 2
				cabBusBuffer[1] = 0x21;
				cabBusBuffer[2] = (c.locoAddress >> 8) & 0xFF;  // Locomotive Address
				cabBusBuffer[3] = c.locoAddress & 0xFF;
				cabBusBuffer[4] = c.functionGroup2;  // F8 F7 F6 F5
				cabBusPktQueuePush(&cabBusTxQueue, cabBusBuffer, 5);
			}
			else
			{
				cabBusBuffer[0] = (c.locoAddress >> 7) & 0x7F;  // Locomotive Address
				cabBusBuffer[1] = c.locoAddress & 0x7F;
				cabBusBuffer[2] = 0x08;  // Function Group 2
				cabBusBuffer[3] = c.functionGroup2;
				cabBusPktQueuePush(&cabBusTxQueue, cabBusBuffer, 4);
			}
		}

		if(IS_LOCO_ADDRESS_CHANGED(delta) || IS_FN_GROUP_3_CHANGED(delta))
		{
			if(enableXpressnet)
			{
				cabBusBuffer[0] = 0xE4;  // Function Group 3
				cabBusBuffer[1] = 0x22;
				cabBusBuffer[2] = (c.locoAddress >> 8) & 0xFF;  // Locomotive Address
				cabBusBuffer[3] = c.locoAddress & 0xFF;
				cabBusBuffer[4] = c.functionGroup3;  // F12 F11 F10 F9
				cabBusPktQueuePush(&cabBusTxQueue, cabBusBuffer, 5);
			}
			else
			{
				cabBusBuffer[0] = (c.locoAddress >> 7) & 0x7F;  // Locomotive Address
				cabBusBuffer[1] = c.locoAddress & 0x7F;
				cabBusBuffer[2] = 0x09;  // Function Group 3
				cabBusBuffer[3] = c.functionGroup3;
				cabBusPktQueuePush(&cabBusTxQueue, cabBusBuffer, 4);
			}
		}

		if(IS_LOCO_ADDRESS_CHANGED(delta) || IS_FN_GROUP_4_CHANGED(delta))
		{
			if(enableXpressnet)
			{
				cabBusBuffer[0] = 0xE4;  // Function Group 4 (http://www.opendcc.net/elektronik/opendcc/xpressnet_commands_e.html)
				cabBusBuffer[1] = 0x23;
				cabBusBuffer[2] = (c.locoAddress >> 8) & 0xFF;  // Locomotive Address
				cabBusBuffer[3] = c.locoAddress & 0xFF;
				cabBusBuffer[4] = c.functionGroup4;  // F20 - F13
				cabBusPktQueuePush(&cabBusTxQueue, cabBusBuffer, 5);
			}
			else
			{
				cabBusBuffer[0] = (c.locoAddress >> 7) & 0x7F;  // Locomotive Address
				cabBusBuffer[1] = c.locoAddress & 0x7F;
				cabBusBuffer[2] = 0x15;  // Function Group 4
				cabBusBuffer[3] = c.functionGroup4;
				cabBusPktQueuePush(&cabBusTxQueue, cabBusBuffer, 4);
			}
		}

		if(IS_LOCO_ADDRESS_CHANGED(delta) || IS_FN_GROUP_5_CHANGED(delta))
		{
			if(enableXpressnet)
			{
				cabBusBuffer[0] = 0xE4;  // Function Group 5 (http://www.opendcc.net/elektronik/opendcc/xpressnet_commands_e.html)
				cabBusBuffer[1] = 0x28;
				cabBusBuffer[2] = (c.locoAddress >> 8) & 0xFF;  // Locomotive Address
				cabBusBuffer[3] = c.locoAddress & 0xFF;
				cabBusBuffer[4] = c.functionGroup5;  // F28 - F21
				cabBusPktQueuePush(&cabBusTxQueue, cabBusBuffer, 5);
			}
			else
			{
				cabBusBuffer[0] = (c.locoAddress >> 7) & 0x7F;  // Locomotive Address
				cabBusBuffer[1] = c.	locoAddress & 0x7F;
				cabBusBuffer[2] = 0x16;  // Function Group 5
				cabBusBuffer[3] = c.functionGroup5;
				cabBusPktQueuePush(&cabBusTxQueue, cabBusBuffer, 4);
			}
		}
		
		updateCabData(rxBuffer[MRBUS_PKT_SRC], &c);
	}

	//*************** END PACKET HANDLER  ***************

	
	//*************** RECEIVE CLEANUP ***************
PktIgnore:
	// Yes, I hate gotos as well, but sometimes they're a really handy and efficient
	// way to jump to a common block of cleanup code at the end of a function 

	// This section resets anything that needs to be reset in order to allow us to receive
	// another packet.  Typically, that's just clearing the MRBUS_RX_PKT_READY flag to 
	// indicate to the core library that the mrbus_rx_buffer is clear.
	return;	
}

volatile uint8_t ticks;
volatile uint16_t decisecs = 0;

void initialize100HzTimer(void)
{
	// Set up timer 0 for 100Hz interrupts
	TCNT0 = 0;
	OCR0A = 195;  // 20MHz / 1024 / 195 = 100.16Hz
	ticks = 0;
	decisecs = 0;
	TCCR0A = _BV(WGM01);
	TCCR0B = _BV(CS02) | _BV(CS00);
	TIMSK0 |= _BV(OCIE0A);
}

ISR(TIMER0_COMPA_vect)
{
	if (++ticks >= 10)  // 100ms
	{
		ticks = 0;
		decisecs++;
		
		if(mrbeeCollisionTimer)
			mrbeeCollisionTimer--;

		if(cabBuscollisionTimer)
			cabBuscollisionTimer--;
		
		if(blink)
			blink--;
		else
			blink = BLINK_RATE;
	}
	
	if(responseTimer)
		responseTimer--;

	if(xbeeRxTimer)
		xbeeRxTimer--;

	if(pingTimer)
		pingTimer--;
}

void init(void)
{
	// Clear watchdog (in the case of an 'X' packet reset)
	MCUSR = 0;
#ifdef ENABLE_WATCHDOG
	// If you don't want the watchdog to do system reset, remove this chunk of code
	wdt_reset();
	WDTCSR |= _BV(WDE) | _BV(WDCE);
	WDTCSR = _BV(WDE) | _BV(WDP2) | _BV(WDP1); // Set the WDT to system reset and 1s timeout
	wdt_reset();
#else
	wdt_reset();
	wdt_disable();
#endif

	// Configure DIP switches
	DDRA = 0;     // Inputs
	PORTA = 0xFF; // Pullups enabled
	DDRC = 0;     // Inputs
	PORTC = 0xFF; // Pullups enabled

	// Configure status LEDs
	PORTB &= ~(_BV(PB0) | _BV(PB1) | _BV(PB2) | _BV(PB3));
	DDRB |= (_BV(PB0) | _BV(PB1) | _BV(PB2) | _BV(PB3));

	// Configure test mode input (short pin 4 and 6 of AVR programming connector to enable)
	DDRB &= ~_BV(PB5);   // Set PB5 (MOSI) as input
	PORTB |= _BV(PB5);  // Turn on PB5 pull-up

	initialize100HzTimer();
}

uint8_t reverseBits(uint8_t b) {
   b = (b & 0xF0) >> 4 | (b & 0x0F) << 4;
   b = (b & 0xCC) >> 2 | (b & 0x33) << 2;
   b = (b & 0xAA) >> 1 | (b & 0x55) << 1;
   return b;
}

void readDipSwitches(void)
{
	static uint8_t oldSw1 = 0x00;
	static uint8_t oldSw2 = 0x00;
	static uint8_t first = 1;

	// Invert and swap bit order
	uint8_t sw1 = ~PINA;
	uint8_t sw2 = reverseBits(~PINC);

	if(first || (oldSw1 != sw1) || (oldSw2 != sw2))
	{
		enableXpressnet = sw2 & 0x80;

		cabBusInit(sw1 & 0x3F, enableXpressnet);
		mrbus_dev_addr = 0xD0 + (sw2 & 0x1F);

		enableFastTime = sw2 & 0x20;
		
		oldSw1 = sw1;
		oldSw2 = sw2;
	}
	first = 0;
}

uint8_t adjustCabBusASCII(uint8_t chr)
{
	if(chr & 0x20)
		return(chr & 0x3F);  // Clear bit 6 & 7
	else
		return(chr & 0x7F);  // Clear only bit 7
}

int main(void)
{
	uint8_t mrbusTxBuffer[MRBUS_BUFFER_SIZE];
	uint16_t decisecs_tmp = 0;
	
	init();

	wdt_reset();
	
	// Initialize MRBus core
	mrbusPktQueueInitialize(&mrbeeTxQueue, mrbusTxPktBufferArray, MRBUS_TX_BUFFER_DEPTH);
	mrbusPktQueueInitialize(&mrbeeRxQueue, mrbusRxPktBufferArray, MRBUS_RX_BUFFER_DEPTH);

	cabBusPktQueueInitialize(&cabBusTxQueue, cabBusTxPktBufferArray, CABBUS_TX_BUFFER_DEPTH);
	cabBusPktQueueInitialize(&cabBusRxQueue, cabBusRxPktBufferArray, CABBUS_RX_BUFFER_DEPTH);

	readDipSwitches();  // cabBusInit will be called here
	mrbeeInit();

	sei();	

	wdt_reset();

	// Fire off initial reset version packet
	createVersionPacket(0xFF, mrbusTxBuffer);
	mrbusPktQueuePush(&mrbeeTxQueue, mrbusTxBuffer, mrbusTxBuffer[MRBUS_PKT_LEN]);

	wdt_reset();

	while(1)
	{
		wdt_reset();

		readDipSwitches();
		
		ATOMIC_BLOCK(ATOMIC_RESTORESTATE)
		{
			decisecs_tmp = decisecs;
		}
		if(decisecs_tmp >= 10)
		{
			// Send "I'm here" message every second so throttles know communication is active
			createVersionPacket(0xFF, mrbusTxBuffer);
			mrbusPktQueuePush(&mrbeeTxQueue, mrbusTxBuffer, mrbusTxBuffer[MRBUS_PKT_LEN]);
			
			// Also update timeout timers
			uint8_t addr = 0;
			do
			{
				if(mrbusTimer[addr])
				{
					mrbusTimer[addr]--;
					if(0 == mrbusTimer[addr])
					{
						// Send stop if timer is zero
						sendSpeedDirection(getCabBusLocoAddress(addr), getCabBusSpeedDirection(addr) & 0x80);
					}
				}
				addr++;
			} while(addr);
			
			ATOMIC_BLOCK(ATOMIC_RESTORESTATE)
			{
				decisecs -= 10;
			}
		}

		// Handle any MRBus packets that may have come in
		if (mrbusPktQueueDepth(&mrbeeRxQueue))
		{
			PktHandler();
		}

		// Transmit any pending MRBus packets
		if (mrbusPktQueueDepth(&mrbeeTxQueue))
		{
			wdt_reset();
			mrbeeTransmit();
		}

		// Handle any incoming Cab Bus data
		if(!enableXpressnet && cabBusPktQueueDepth(&cabBusRxQueue))
		{
			uint8_t rxBuffer[CABBUS_BUFFER_SIZE];

			if (0 != cabBusPktQueuePop(&cabBusRxQueue, rxBuffer, sizeof(rxBuffer)))
			{
				switch(rxBuffer[3])
				{
					case 0xC1:
						// Fast Time ASCII
						fastTime.hours = ((adjustCabBusASCII(rxBuffer[5]) - '0') * 10) + (adjustCabBusASCII(rxBuffer[6]) - '0');
						fastTime.minutes = ((adjustCabBusASCII(rxBuffer[8]) - '0') * 10) + (adjustCabBusASCII(rxBuffer[9]) - '0');
						if('A' == (adjustCabBusASCII(rxBuffer[10])))
						{
							timeFlags |= TIME_FLAGS_DISP_FAST_AMPM;
							if(fastTime.hours > 11)
								fastTime.hours -= 12;
						}
						else if('P' == (adjustCabBusASCII(rxBuffer[10])))
						{
							timeFlags |= TIME_FLAGS_DISP_FAST_AMPM;
							if(fastTime.hours < 12)
								fastTime.hours += 12;
						}
						else
						{
							timeFlags &= ~TIME_FLAGS_DISP_FAST_AMPM;
						}
						timeFlags |= TIME_FLAGS_DISP_FAST;
						if(enableFastTime)
						{
							createTimePacket(mrbusTxBuffer);
							mrbusPktQueuePush(&mrbeeTxQueue, mrbusTxBuffer, mrbusTxBuffer[MRBUS_PKT_LEN]);
						}
						break;
					case 0xD4:
						// Fast Time Ratio
						timeScaleFactor = ((uint16_t)(rxBuffer[4] & 0x3F)) * 10;
						timeFlags |= TIME_FLAGS_DISP_FAST;
						if(enableFastTime)
						{
							createTimePacket(mrbusTxBuffer);
							mrbusPktQueuePush(&mrbeeTxQueue, mrbusTxBuffer, mrbusTxBuffer[MRBUS_PKT_LEN]);
						}
						break;
				}
			}
		}

		// Handle any pending Cab Bus packets
		if(cabBusPktQueueDepth(&cabBusTxQueue))
		{
			// Packet pending, so queue it up for transmit
			wdt_reset();
			cabBusTransmit();
		}
		
		// Deal with status LEDs from Cab Bus
		if(cabBusPing())
		{
			pingTimer = PING_LED_TIME;
		}

		if(cabBusResponse())
		{
			responseTimer = RESPONSE_LED_TIME;
		}

		if(cabBusCollision())
		{
			cabBuscollisionTimer = COLLISON_LED_TIME;
		}

		
		// Set/clear LEDs
		if(PINB & _BV(PB5))
		{
			if(pingTimer)
				setLed(PING);
			else
				clearLed(PING);

			if(responseTimer)
				setLed(RESPONSE);
			else
				clearLed(RESPONSE);

			if(xbeeRxTimer)
				setLed(XBEE_RX);
			else
				clearLed(XBEE_RX);

			if(cabBuscollisionTimer)
				setLed(COLLISON);
			else if(mrbeeCollisionTimer)
			{
				if(blink / (BLINK_RATE / 2))
					setLed(COLLISON);
				else
					clearLed(COLLISON);
			}
			else
				clearLed(COLLISON);
		}
		else
		{
			// Test Mode
			uint8_t sw1 = ~PINA;
			uint8_t sw2 = reverseBits(~PINC);
			if((0b00100000 == sw2) && (0b00000100 == sw1))  // Default: Cab Bus mode, FT enabled, Base = 0, Cab = 4
			{
				setLed(COLLISON);
			}
			else
			{
				clearLed(COLLISON);
			}

			if((0 == PINA) && (0 == PINC))
			{
				setLed(RESPONSE);
				clearLed(XBEE_RX);
				clearLed(PING);
			}
			else if((0xFF == PINA) && (0xFF == PINC))
			{
				clearLed(RESPONSE);
				clearLed(XBEE_RX);
				setLed(PING);
			}
			else
			{
				clearLed(RESPONSE);
				setLed(XBEE_RX);
				clearLed(PING);
			}
		}

	}

}
