IowaScaledEngineering/mrbw-cabbus/src/cabbus/src/cabbus-macros.h

#ifndef CABBUS_MACROS_H
#define CABBUS_MACROS_H

// Common macros for handling 16 bit variables
// These aren't strictly part of Cab Bus, but are used through the code and need to be defined
#ifndef UINT16_HIGH_BYTE
#define UINT16_HIGH_BYTE(a)  ((a)>>8)
#endif 

#ifndef UINT16_LOW_BYTE
#define UINT16_LOW_BYTE(a)  ((a) & 0xFF)
#endif 

#ifndef min
#define min(a,b)  ((a)<(b)?(a):(b))
#endif

#ifndef max
#define max(a,b)  ((a)>(b)?(a):(b))
#endif


#endif 
