IowaScaledEngineering/mrbw-cabbus/(commit log)

2017-09-20 Initial commit (non-working, copied from mrbw-xpressnet, and probably broken)
    [cabbus-constants.h, cabbus-macros.h, cabbus-queue.c, cabbus-queue.h, cabbus.c, cabbus.h, mrbw-cabbus.c]
2017-09-21 Working with NCE power cab. Yea!
2017-09-22 Changed _delay_us(300) to timer2 driven delay to prevent blocking execution (and possibly missing MRBee packets)
    [cabbus.c]
2017-09-25 Added short address support.
    [mrbw-cabbus.c]
2017-10-15 Fixed calculation of 12AM and 12PM
    [mrbw-cabbus.c]
2017-10-26 Wiring diagram
    [addresses.ods]
2017-11-18 Refactored ISR code to eliminate missed pings Confirmed to work, but fast time processing currently missing.
    [cabbus.c]
2017-11-19 Fixed fast time processing
    [cabbus.c, mrbw-cabbus.c]
2017-11-26 Changed to only send speed/direction if no changes are received from throttle. Made cache macros safer.
2017-12-23 Initial version of board
    [mrbw-cabbus.sch]
2017-12-28 Updated refdes
    [mrbw-cabbus.sch]
2017-12-28 Initial layout
    [mrbw-cabbus.pcb, mrbw-cabbus.sch]
2017-12-28 More layout
    [mrbw-cabbus.pcb, mrbw-cabbus.sch]
2017-12-29 Layout done. DRC/LVS clean.
    [mrbw-cabbus.pcb]
2017-12-29 Adjusted text and add + to status LEDs
    [mrbw-cabbus.pcb]
2017-12-30 Removed USB, added diodes to power inputs
    [mrbw-cabbus.pcb, mrbw-cabbus.sch]
2017-12-30 Fixed stupid mistakes
    [mrbw-cabbus.pcb, mrbw-cabbus.sch]
2017-12-30 Removed GND plane from R4. Fixed D6-D9 wires.
    [mrbw-cabbus.pcb]
2017-12-30 Increased via drill to 12mil
    [mrbw-cabbus.pcb]
2017-12-31 Tweaked some placements and metal
    [mrbw-cabbus.pcb]
2017-12-31 Fixed MCP1703 part #
    [mrbw-cabbus.sch]
2018-01-03 Fixed XBee sleep connection. DRC/LVS Clean.
    [mrbw-cabbus.pcb, mrbw-cabbus.sch]
2018-01-03 PG'd 1/2/2018
    [mrbw-cabbus.bottom.gbr, mrbw-cabbus.bottommask.gbr, mrbw-cabbus.bottompaste.gbr, mrbw-cabbus.bottomsilk.gbr, mrbw-cabbus.fab.gbr, mrbw-cabbus.outline.gbr, mrbw-cabbus.top.gbr, mrbw-cabbus.topmask.gbr]
2018-02-04 Initial cut at the firmware for the new hardware. Mostly works.
2018-02-06 Added detection and reporting of MRBee collisions
    [mrbw-cabbus.c]
2018-02-06 Added collision detection to XpressNet ISR
    [cabbus.c]
2018-03-06 Updated R values for LEDs
    [mrbw-cabbus.sch]
2018-04-10 Updated Makefile to iseavrprog, removed -F switch
2018-09-03 Fixed issue with caching consist address on Smart Cabs Fixes #7
    [cabbus-cache.h, mrbw-cabbus.c]
2018-09-03 Masked off bits when assigning locomotive address. Fixes #4
    [mrbw-cabbus.c]
2018-09-03 Added conditional around code that processes incoming cab bus data. Fixes #5
    [mrbw-cabbus.c]
2018-09-04 Added timeout after 60 seconds. Stops locomotive. Fixes #6
    [cabbus-cache.c, cabbus-cache.h, mrbw-cabbus.c]
2019-02-08 New XB3 schematic
    [mrbw-cabbus.sch]
2019-02-08 Changed XB3 refdes to U6
    [mrbw-cabbus.sch]
2019-02-15 v2 layout
    [mrbw-cabbus.pcb, mrbw-cabbus.sch]
2019-02-15 Tweaked text
    [mrbw-cabbus.pcb]
2019-02-19 Removed metal under XBee antenna. DRC/LVS clean.
    [mrbw-cabbus.pcb]
2019-02-26 Minor trace cleanup
    [mrbw-cabbus.pcb]
2019-03-04 Sent to fab
    [mrbw-cabbus.bottom.gbr, mrbw-cabbus.bottommask.gbr, mrbw-cabbus.bottompaste.gbr, mrbw-cabbus.bottomsilk.gbr, mrbw-cabbus.fab.gbr, mrbw-cabbus.outline.gbr, mrbw-cabbus.top.gbr, mrbw-cabbus.topmask.gbr]
2019-06-10 Updated manual with new board image
2019-12-14 Fixed D4/D5 polarity indicator. v2.1
    [mrbw-cabbus.pcb]
2019-12-14 v2.1 fab files
    [mrbw-cabbus.bottom.gbr, mrbw-cabbus.bottommask.gbr, mrbw-cabbus.bottompaste.gbr, mrbw-cabbus.bottomsilk.gbr, mrbw-cabbus.fab.gbr, mrbw-cabbus.outline.gbr, mrbw-cabbus.top.gbr, mrbw-cabbus.topmask.gbr]
2020-09-11 Changed out Recom for AP63205
    [mrbw-cabbus.pcb, mrbw-cabbus.sch]
2020-09-11 Updated version and (c) date
    [mrbw-cabbus.pcb]
2020-09-11 Rotated R4 90 deg
    [mrbw-cabbus.pcb]
2020-09-13 Tightened 5V regulator layout
    [mrbw-cabbus.pcb]
2020-09-13 Tweaked refdes positions
    [mrbw-cabbus.pcb]
2020-09-13 Cleanup around 5V regulator
    [mrbw-cabbus.pcb]
2020-09-15 Sent to fab 9/13/2020
    [mrbw-cabbus.bottom.gbr, mrbw-cabbus.bottommask.gbr, mrbw-cabbus.bottompaste.gbr, mrbw-cabbus.bottomsilk.gbr, mrbw-cabbus.fab.gbr, mrbw-cabbus.outline.gbr, mrbw-cabbus.top.gbr, mrbw-cabbus.topmask.gbr]
2021-06-09 NCE wiring diagram
2022-09-20 v2.3 with no r-packs
    [mrbw-cabbus.pcb, mrbw-cabbus.sch]
2022-10-16 PG v2.3
    [mrbw-cabbus.bottom.gbr, mrbw-cabbus.bottommask.gbr, mrbw-cabbus.bottompaste.gbr, mrbw-cabbus.bottomsilk.gbr, mrbw-cabbus.fab.gbr, mrbw-cabbus.outline.gbr, mrbw-cabbus.top.gbr, mrbw-cabbus.topmask.gbr]
